COSMIIC-Community/NOVA/README.md

# COSMIIC-NOVA
Open-source high channel count impantable devices

## NOVA BACKGROUND
NOVA or "Neural Open-source Versatile Array" is a sub-project of the Cleveland Open Source Modular Implant Innovators Community (COSMIIC). The project goal is to design high channel count implantable medical devices for neural recording and modulation that can be added as modules to the COSMIIC system. Within each device folder, you will find sub-folders that contain documentation of the enclosure and electronics design, testing, and regulatory communications. More information on the COSMIIC system can be found [here](https://cosmiic.org/).

## NOVA TEAM
Electronics design: Cynthia Chestek, Alex Vaskov, Dylan Wallace, Olivia Lee  
Mechanical design: Doug Shire, Janet Gbur, Sonny Behan  
Regulatory Sponsorship: Paul Cederna  
COSMIIC Integration: Kevin Kilgore, Brian Smith, Joris Lambrecht, Jeremiah Ukwela  

## LICENSING
All of our design files are open-source! You are free to reference, share, and adapt this material according to Creative Commons License Attribution 4.0 ([CC-By-4.0](https://creativecommons.org/licenses/by/4.0/)).
This license requires you to give appropriate credit and indiciate if changes were made. Attribution should be made to either Case Western Reserve University and/or University of Michigan. Attribution instructions are also found in each sub-folder. General instructions can be found [here](https://wiki.creativecommons.org/wiki/best_practices_for_attribution).

## FUNDING
This effort is funded by the National Institute of Health under the SPARC Human Open Research Neural Engineering Technologies (HORNET) Initiative. Award 1U41NS129436-01 sub-project 7004.
 
## DISCLAIMER
The contents of this repository are subject to revision. No representation or warranty, express or implied, is provided in relation to the accuracy, correctness, completeness, or reliability of the information, opinions, or conclusions expressed in this repository.

The contents of this repository (the “Materials”) are experimental in nature and should be used with prudence and appropriate caution. Any use is voluntary and at your own risk.

The Materials are made available “as is” by UM (the University of Michigan and its trustees, directors, officers, employees, faculty, students, agents, affiliated organizations and their insurance carriers, if any), and any other contributors to this repository (collectively, “Providers”). Providers expressly disclaim all warranties, express or implied, arising in connection with the Materials, or arising out of a course of performance, dealing, or trade usage, including, without limitation, any warranties of title, noninfringement, merchantability, or fitness for a particular purpose.

Any user of the Materials agrees to forever indemnify, defend, and hold harmless Providers from and against, and to waive any and all claims against Providers for any and all claims, suits, demands, liability, loss or damage whatsoever, including attorneys' fees, whether direct or consequential, on account of any loss, injury, death or damage to any person or (including without limitation all agents and employees of Providers and all property owned by, leased to or used by either Providers) or on account of any loss or damages to business or reputations or privacy of any persons, arising in whole or in part in any way from use of the Materials or in any way connected therewith or in any way related thereto.
