COSMIIC-Community/NOVA/64 Channel Recording Module/FDA Communications/README.md

# Electronics Pre-Sub External Testing

## DESCRIPTION
Contains FDA pre-submission communications to add the NOVA (previously named HIVE) recording module to a pre-existing IDE that uses implanted electrodes. Sensitive information related to the existing IDE and clinical trial has been redacted from the documents.

## LICENSING
All of our design files are open-source! You are free to reference, share, and adapt this material according to Creative Commons License Attribution 4.0 ([CC-By-4.0](https://creativecommons.org/licenses/by/4.0/)). This license requires you to give appropriate credit and indiciate if changes were made. Attribution should be made to University of Michigan. Example statements can be found [here](https://wiki.creativecommons.org/wiki/best_practices_for_attribution).
