COSMIIC-Community/NOVA/64 Channel Recording Module/Design/PCB/Development Board V0.1/NOVA_DEV_V0-1_Picture.png

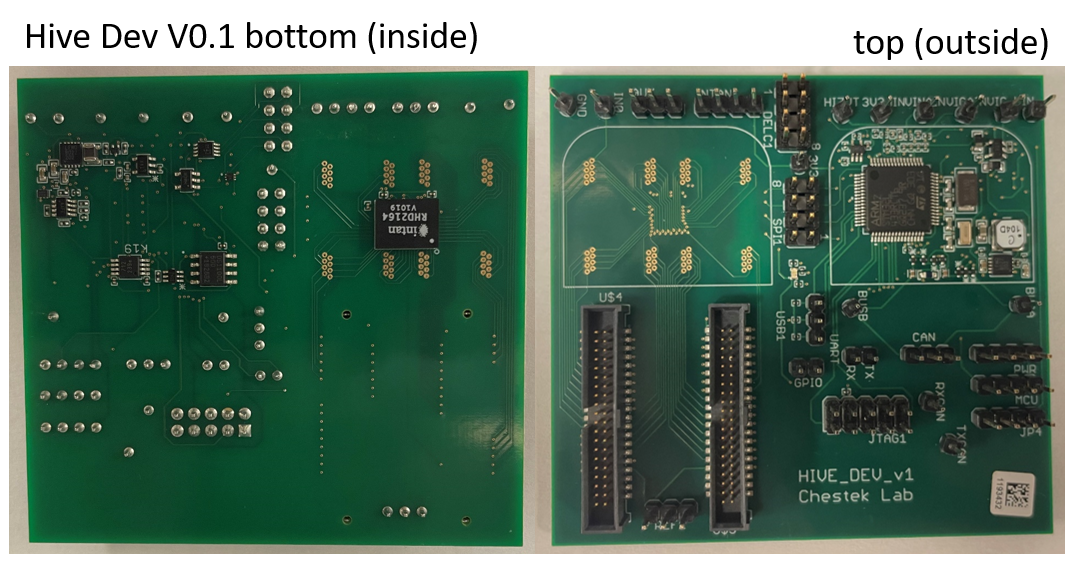
64 Channel Recording Module/Design/PCB/Development Board V0.1/NOVA_DEV_V0-1_Picture.png
