COSMIIC-Community/NOVA/64 Channel Recording Module/Design/PCB/NOVA V1/Output/BOM/BOM-UM-64NNP-V1.xlsx

Quantity | Designator | Description | Manufacturer | Manufacturer PN | Supplier 1 | Supplier Part Number 1
21 | C1, C8, C9, C12, C16, C20, C21, C22, C23, C24, C25, C26, C27, C34, C35, C39, C41, C42, C43, C701, C702 | Capacitor, Ceramic, 0.1uF, X7R, 16V, 10%, 0402 | Murata | GCM155R71C104KA55J | Digikey | 490-7998-1-ND
2 | C2, C3 | Capacitor, Ceramic, 8.0pF, C0G, 50V, 0.05pF, 0402 | Murata | GJM1555C1H8R0WB01D | Mouser | 81-GJM1555C1H8R0WB1D
6 | C4, C28, C36, C40, C44, C102 | Capacitor, Ceramic, 4.7uF, X5R, 10V, 20%, 0402 | Murata | GRM155R61A475MEAAD | Mouser | 81-GRM155R61A475MEAD
3 | C5, C33, C703 | Capacitor, Ceramic, 10nF, X7R, 25V, 10%, 0402 | KEMET | C0402C103J3RACTU | Mouser | 80-C0402C103J3R
2 | C6, C103 | Capacitor, Ceramic, 10uF, X5R, 10V, 20%, 0402 | Murata | GRM155R61A106ME11D | Mouser | 81-GRM155R61A106ME1D
2 | C7, C17 | Capacitor, Ceramic, 0.1uF, X7R, 100V, 10%, 0603 | Kyocera AVX | 06031C104K4Z2A | Mouser | 581-06031C104K4Z2A
2 | C10, C11 | Capacitor, Ceramic, 47uF, X5R, 25V, 20%, 1206 | Murata | C3216X5R1E476M160AC | Mouser | 810-C3216X5R1E476M
11 | C13, C14, C18, C19, C29, C31, C32, C101, C201, C202, C203 | Capacitor, Ceramic, 1.0uF, X5R, 25V, 10%, 0402 | TDK | CGB2A1X5R1E105K033BC | Mouser | 810-CGB2A1X5R1E105BC
2 | C15, C38 | Capacitor, Ceramic, 5.6pF, C0G, 50V, 10%, 0402 | Murata | GRM1555C1H5R6WA01D | Mouser | 81-GRM1555C1H5R6WA1D
1 | C30 | Capacitor, Ceramic, 68pF, C0G, 50V, 5%, 0402 | Murata | GRM1555C1H680JA01D | Mouser | 81-GRM1555C1H680JA1D
1 | C37 | Capacitor, Ceramic, 680pF, C0G, 100V, 5%, 0603 | Murata | GCM1885C2A681JA16D | Mouser | 81-GCM1885C2A681J16D
64 | C811, C812, C813, C814, C815, C816, C817, C818, C821, C822, C823, C824, C825, C826, C827, C828, C831, C832, C833, C834, C835, C836, C837, C838, C841, C842, C843, C844, C845, C846, C847, C848, C851, C852, C853, C854, C855, C856, C857, C858, C861, C862, C863, C864, C865, C866, C867, C868, C871, C872, C873, C874, C875, C876, C877, C878, C881, C882, C883, C884, C885, C886, C887, C888 | Capacitor, Ceramic, 680pF, C0G, 100V, 5%, 0402 | TDK | CGA2B1C0G2A681J050BC | Mouser | 810-CGA2B1C0G2A681J5
1 | D1 | LED Green 20mA 2.2V 45mcd 0402 | Lumex | SML-LX0402SUGC-TR | Mouser | 696-SML-LX0402SUGCTR
1 | D2 | LED, Blue, 2mA, 2.65V, 15mcd, 0402 | Kingbright | APHHS1005LQBC/D-V | Mouser | 604-APHHS1005LQBC/DV
7 | D5, D6, D7, D8, D9, D11, D12 | Diode, Schottky, 30V, 100mA, SOD-923 | Toshiba | 1SS416,L3M | Mouser | 757-1SS416L3M
64 | D811, D812, D813, D814, D815, D816, D817, D818, D821, D822, D823, D824, D825, D826, D827, D828, D831, D832, D833, D834, D835, D836, D837, D838, D841, D842, D843, D844, D845, D846, D847, D848, D851, D852, D853, D854, D855, D856, D857, D858, D861, D862, D863, D864, D865, D866, D867, D868, D871, D872, D873, D874, D875, D876, D877, D878, D881, D882, D883, D884, D885, D886, D887, D888 | TVS Diode, Bidirectional, ±5.3V, 3.0A, SOD-882 | Littelfuse | SP3022-01ETG | Mouser | 576-SP3022-01ETG
5 | FB1, FB2, FB3, FB4, FB5 | Ferrite Bead, 700mA, 0402 | Murata | BLM15EG221SH1D | Mouser | 81-BLM15EG221SH1D
1 | J1 | Connector, 1.27 mm, 2x5, Male, TH | Samtec | FTSH-105-01-F-D-K | Mouser | 200-FTSH10501FDK
1 | J2 | Header, Male, TH, 2.54mm, 1x7 | Samtec | TSW-107-07-F-S | Mouser | 200-TSW10707FS
1 | L1 | Inductor, 2.2uH, 1.76A, 1008 | TDK | VLS252010HBX-2R2M-1 | Mouser | 810-VLS25201HBX2R2M1
1 | L6 | Inductor, Unshielded, 33nH, 350mA, 0402 | Murata | LQG15HS33NJ02D | Mouser | 81-LQG15HS33NJ02D
2 | L101, L201 | Inductor, Shielded, 47uH, 20%, 0.380A | Coilcraft | LPS4012-473MRC | Mouser | 994-LPS4012-473MRC
1 | M1 | MOSFET, Dual N-chan/P-chan, ±60V, SOT563 | Diodes Inc | DMG1029SV-7 | Mouser | 621-DMG1029SV-7
1 | Q1 | BJT, PNP, -50V, -0.1A, SOT-723 | Rohm | 2SAR523MT2L | Mouser | 755-2SAR523MT2L
3 | R1, R14, R22 | Resistor, 2M, 40V, 40mW, 1%, 0402 | Panasonic | ERJ-2GEJ205X | Mouser | 667-ERJ-2GEJ205X
1 | R2 | Resistor, 10.0k, 1%, 50V, 0.1W, 0402 | Panasonic | ERJ-2RKF1002X | Mouser | 667-ERJ-2RKF1002X
4 | R3, R24, R35, R36 | Resistor, 4.99M, 1%, 50V, 0.062W, 0402 | Vishay Dale | CRCW04024M99FKED | Mouser | 71-CRCW04024M99FKED
3 | R4, R7, R9 | Resistor, Zero ohms, 0603 | Yageo | RC0603JR-100RL | Mouser | 603-RC0603JR-100RL
1 | R8 | Resistor, 0.1, 1%, 50V, 0.25W, 0402 | Panasonic | ERJ-2BWFR100X | Mouser | 667-ERJ-2BWFR100X
2 | R10, R13 | ESD Suppressor, 12V, 0603 | Bourns | CGA0603MLC-12E | Mouser | 652-CGA0603MLC-12E
2 | R11, R20 | Resistor, 4.12M, 50V, 62mW, 1%, 0402 | Vishay Dale | CRCW04024M12FKED | Mouser | 71-CRCW04024M12FKED
5 | R15, R101, R104, R201, R204 | Resistor, Zero ohms, 0402 | Panasonic | ERJ-2GE0R00X | Mouser | 667-ERJ-2GE0R00X
6 | R16, R18, R27, R29, R30, R78 | Resistor, 1k, 1%, 50V, 0.1W, 0402 | Panasonic | ERJ-2RKF1001X | Mouser | 667-ERJ-2RKF1001X
2 | R19, R21 | Resistor, 5.1k, 1%, 50V, 0.1W, 0402 | Panasonic | ERJ-2RKF5101X | Mouser | 667-ERJ-2RKF5101X
4 | R25, R26, R28, R31 | Resistor, 49.9k, 1%, 50V, 0.1W, 0402 | Panasonic | ERJ-2RKF4992X | Mouser | 667-ERJ-2RKF4992X
1 | R32 | Resistor, 84.5k, 1%, 50V, 0.1W, 0402 | Panasonic | ERJ-2RKF8452X | Mouser | 667-ERJ-2RKF8452X
1 | R33 | Resistor, 1.00M, 1%, 50V, 0.1W, 0402 | Panasonic | ERJ-2RKF1004X | Mouser | 667-ERJ-2RKF1004X
2 | U1, U15 | Op Amp, Rail-to-Rail, 95kHz, WLCSP-6 | Analog Devices | AD8505ACBZ-R7 | Digikey | AD8505ACBZ-R7CT-ND
1 | U2 | Microcontroller, ARM Cortex-M4, 32-bit, 4MB Flash, 2.5MB RAM, SMPS, BGA-132 | ST Microelectronics | STM32U5A5QJI6Q | Mouser | 511-STM32U5A5QJI6Q
2 | U3, U6 | LDO, 1-5.5V, ADJ, 150mA, TSOT-23-5 | Analog Devices | ADP161AUJZ-R7 | Mouser | 584-ADP161AUJZ-R7
1 | U4 | Current Sense, HIgh Side, 1.6-28V, 200V/V, SOT23-5 | Maxim | MAX9938FEUK+T | Mouser | 700-MAX9938FEUK+T
1 | U5 | FRAM, 8 Mbit (1024k x 8), SPI, 1.8-3.6V, QFN-8 | Cypress | CY15B108QI-20LPXI | Heisener | CY15B108QI-20LPXI
1 | U8 | Comparator, Dual, 40ns, VSSOP8 | Texas Instruments | TLV3202AQDGKRQ1 | Mouser | 595-TLV3202AQDGKRQ1
2 | U9, U16 | XOR, 5.5V, uPAk6 | ON Semiconductor | NC7SZ86L6X | Arrow Electronics | NC7SZ86L6X
1 | U10 | Digital Isolator, 110Mbps, 2.7-5.5V, uSOP8 | NVE | IL 712-1ETR7 | Digi-Key | 390-IL712-1ETR7CT-ND
1 | U11 | Silicon delay, 3-3.6V, uSOP8 | Maxim | DS1100LU-500+ | Mouser | 700-DS1100LU-500
2 | U12, U17 | D FLIPFLOP, 5.5V, uPAk6 | ON Semiconductor | NC7SZ175L6X | Digikey | NC7SZ175L6XFSCT-ND
1 | U13 | LDO, -1.2-20V, -200mA, SOT23-5 | Analog Devices | LT1964ES5-BYP#PBF | Digi-Key | LT1964ES5-BYP#TRMPBFCT-ND
2 | U101, U201 | Buck Converter, 2.7-20V, 50mA DFN10 | Analog Devices | LTC3388EDD-3#TRPBF | Mouser | 584-C3388EDD-3TRPBF
1 | U701 | Digital Electrophysiology Interface Chip, BGA-104 | Intan Technologies | RHD2164 | Intan Technologies | RHD2164
1 | Y1 | Crystal, 32.768kHz, 6.0pF, 90k, 20ppm | ECS | ECS-.327-6-12-TR | Mouser | 520-ECS-.327-6-12-TR
1 | Y2 | Crystal, 48MHz, 10ppm, 8pF | ECS | ECS-480-8-47B2-CKM-TR | Mouser | 520-ECS480847B2CKMTR
