COSMIIC-Community/NOVA/64 Channel Recording Module/Design/PCB/NOVA V1/Output/ExportSTEP/UM-64NNP-V1 rev 0.18_norail.step

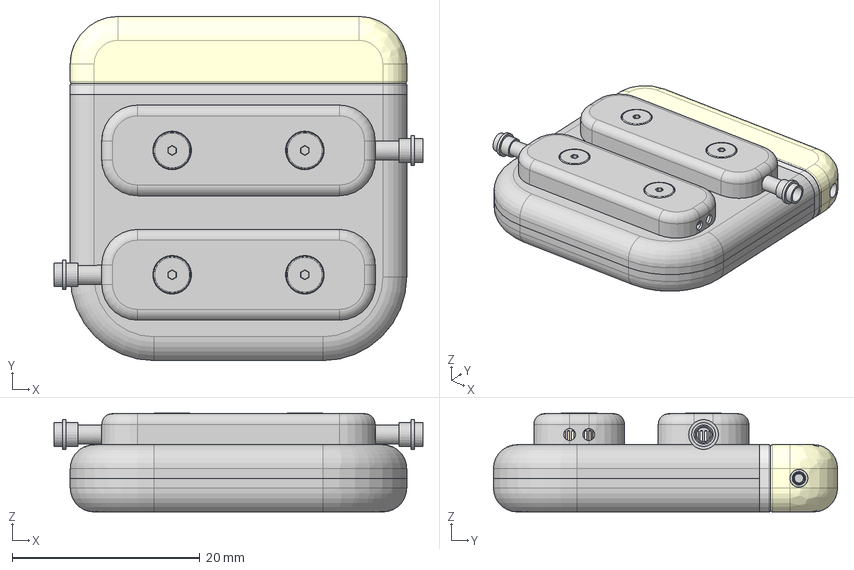
[picture p3: CAD file, 2026-10-12]
64 Channel Recording Module/Design/PCB/NOVA V1/Output/ExportSTEP/UM-64NNP-V1 rev 0.18_norail.step
39.3 x 36.6 x 10.5 mm
capsule x 78
innard x 39
top_cover x 39
Extruded x 356
bigPin x 130
Capsule x 6
Encapsulation x 12
TopCover x 6
LQG15HS3N0S02D
vls252010hbx-1
BGA132CP50_12X12_700X700X60B28
pinShape x 24
ball x 12
BLM15PX331SN1D x 5
LPS4012 x 2
Leader x 31
MSOP-8
Thermal_Shape x 2
lead x 23
64 Stack Square Header_14Mar2023
C12-PM0007-042413 x 2
X572802 CONDUCTOR-042413 x 2
X572802-Washer-042413 x 2
X572802-Spring-042413 x 2
x600883-042413 x 2
X600883-Washer-042413 x 2
X600883-Spring-042413 x 2
Horizontal 64 Stack Square Lidthrough_25Apr2023
Anchor Bracket_15Feb2023
Ground Pin_25Apr2023
Brian Round Bipolar Flange_26Apr2023 x 2
Brian Round Bipolar Feedthrough Wire_25Apr2023 x 4
Brian Round Bipolar Ceramic_26Aug2023 x 2
Horizontal 64 Square Bottom Enclosure_10Feb2024
Weld Band_29Jun2023
Horizontal 64 Square Top Enclosure_10Feb2024
8 Pin Flange_16Sep2022 x 8
8 Pin Ceramic_3Jan2022 x 8
8 Pin Wire_16Sep2022 x 64
2-56 Standoff_30Mar2023 x 4
Doug34setscrew x 4
D64 Long Cap_29Jun2023 x 2
Cap Extension_13Jun2023 x 2
