COSMIIC-Community/NOVA/64 Channel Recording Module/Design/Firmware/manual/Title.md

@mainpage COSMIIC Nova Module Documentation

## Welcome to COSMIIC!

We are establishing and sustaining an open source, modular network of active implantable devices for use in fundamental neuroscience, animal, and early feasibility human research. Our open source concept includes all aspects of the implantable system that are necessary for pre-clinical and human use: hardware, software, mechanical components, test documents, regulatory documents, and instruction manuals. The COSMIIC System has demonstrated success in an early feasibility human study, providing a strong reference for new uses of the device. Our goal with establishing COSMIIC is to make this system available to the entire research community in an open source, collaborative environment.

**Discover more about our technology on our documentation site:** **[docs.cosmiic.org](https://docs.cosmiic.org)**

## Introduction
This website contains documentation for the [Nova Module](https://docs.cosmiic.org/In-Development-Modules/Nova-Module) firmware application repository. The Nova module currently implements a minumum set of features that enable interoperability within the network, based off the COSMIIC generic module template.

## Supported Boards
This Nova codebase is based on the STM32U5 microcontroller unlike the STM32L433 microcontroller used by the generic module firmware. The codebase was written with the use of the STM32 Hardware Abstraction Layer (HAL) and CMSIS, which allows for translation to other STM32 series microcontrollers.

## Licensing
Check the [licensing page](https://docs.cosmiic.org/Community/Licensing) on the [documentation site](https://docs.cosmiic.org) for licensing information.
