COSMIIC-Community/NOVA/64 Channel Recording Module/Design/PCB/Revisions/2024-07-18_UM-64NNP-V1_REWORK1.docx

Document Number | UM-64NNP-V1_REWORK1
Author | Alex Campean
Client | University of Michigan / Chestek Lab
Project | UM-64NNP-V1
Statement of Work | 1. Remove U16 and replace with Texas Instruments SN74LVC1G32DRYR or equivalent OR gate. a. If using hot air, a silicone cover is recommended to protect the flex circuit from damage. b. Recommended re-work settings are 275⁰C hot air, 160⁰C pre-heat, A30 (3rd to last setting) air flow. 2. Cut the EMG_SCK trace going to U17, pin 6 (D Flip Flop CLRn input pin) as shown. 3. Wire an Onsemi NC7SV14P5X or equivalent inverter as shown. a. Pin 2 = EMG_SCK b. Pin 3 = GND c. Pin 4 = U17 pin6 (CLRn) d. Pin 5 = DVDD

Description

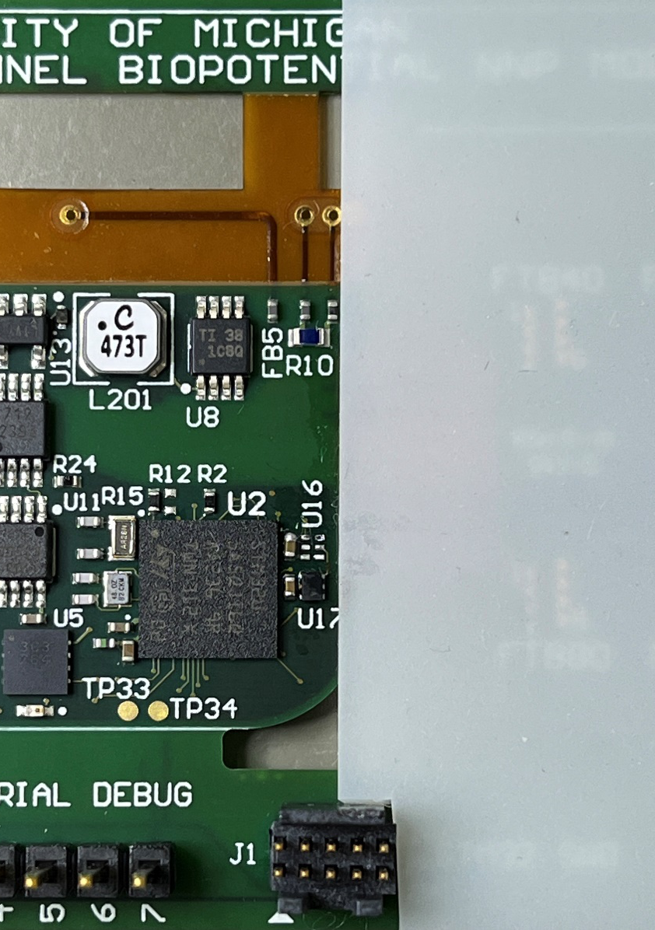
[picture p4: figure]

Remove U16 and replace with

SN74LVC1G32DRYR (replacement part not shown)

Silicone cover to

protect flex area.

Description

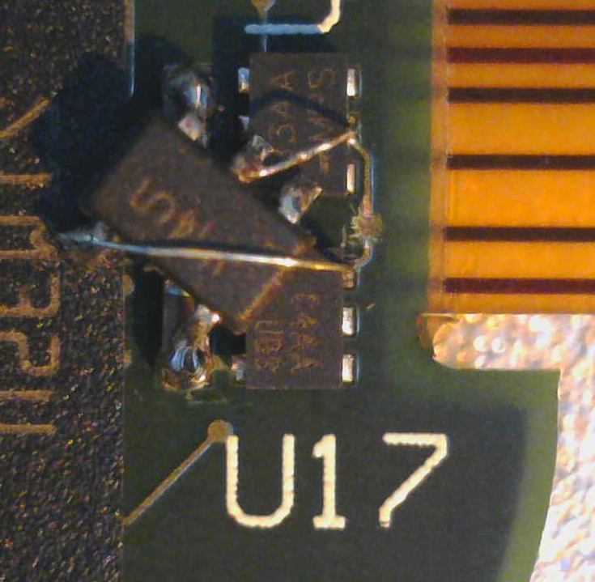
[picture p5: figure]
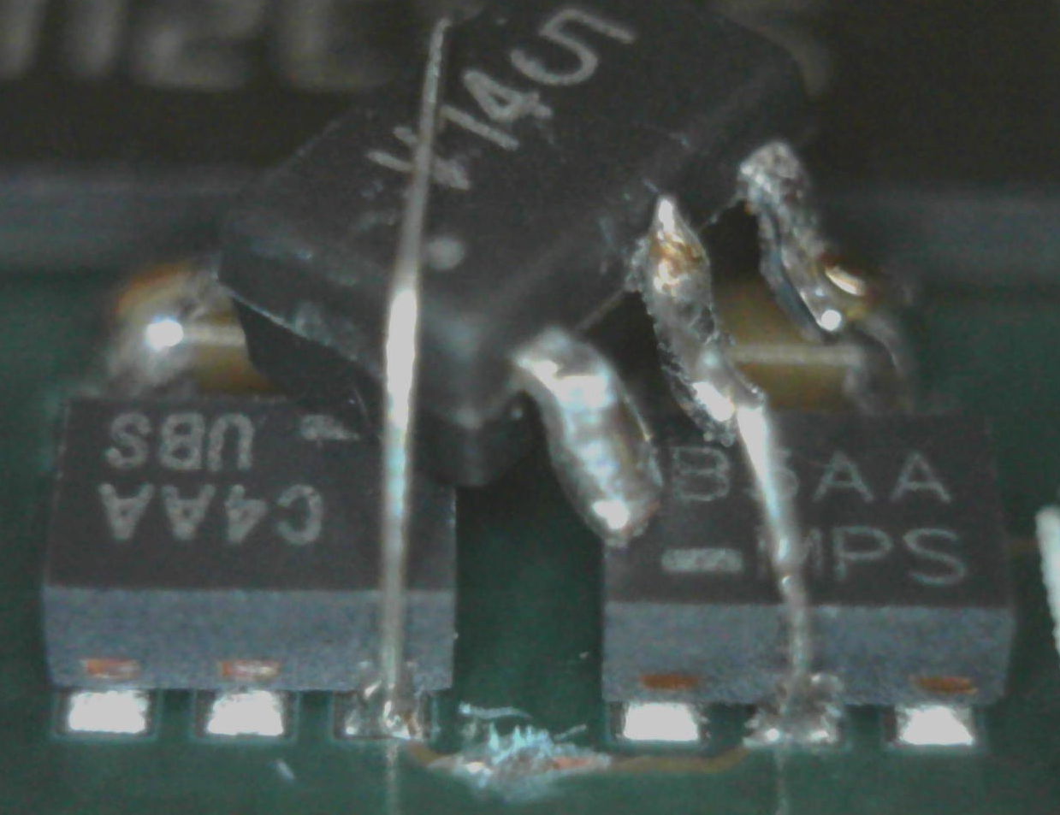
[picture p6: figure]
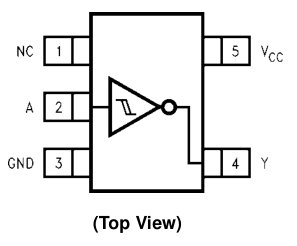
[picture p7: figure]

Cut EMG_SCK trace here

From: EMG_SCK

To: U17 pin6 (CLRn)

NC7SV14P5X

5 = DVDD

4 = U17 pin6 (CLRn)

3 = GND

2 = EMG_SCK

SOLDER

SOLDER

SOLDER

SOLDER

SOLDER

SOLDER

2024-07-18_UM-64NNP-V1_REWORK1.docx 2025-03-05 1:28 PM 2 of 2

Business Confidential Alex Campean acampean@carrollbiomedical.com Al
