COSMIIC-Community/NOVA/64 Channel Recording Module/Design/Mechanical/Design PDFs/NOVA 64ch Assembly.pdf

A | A

6

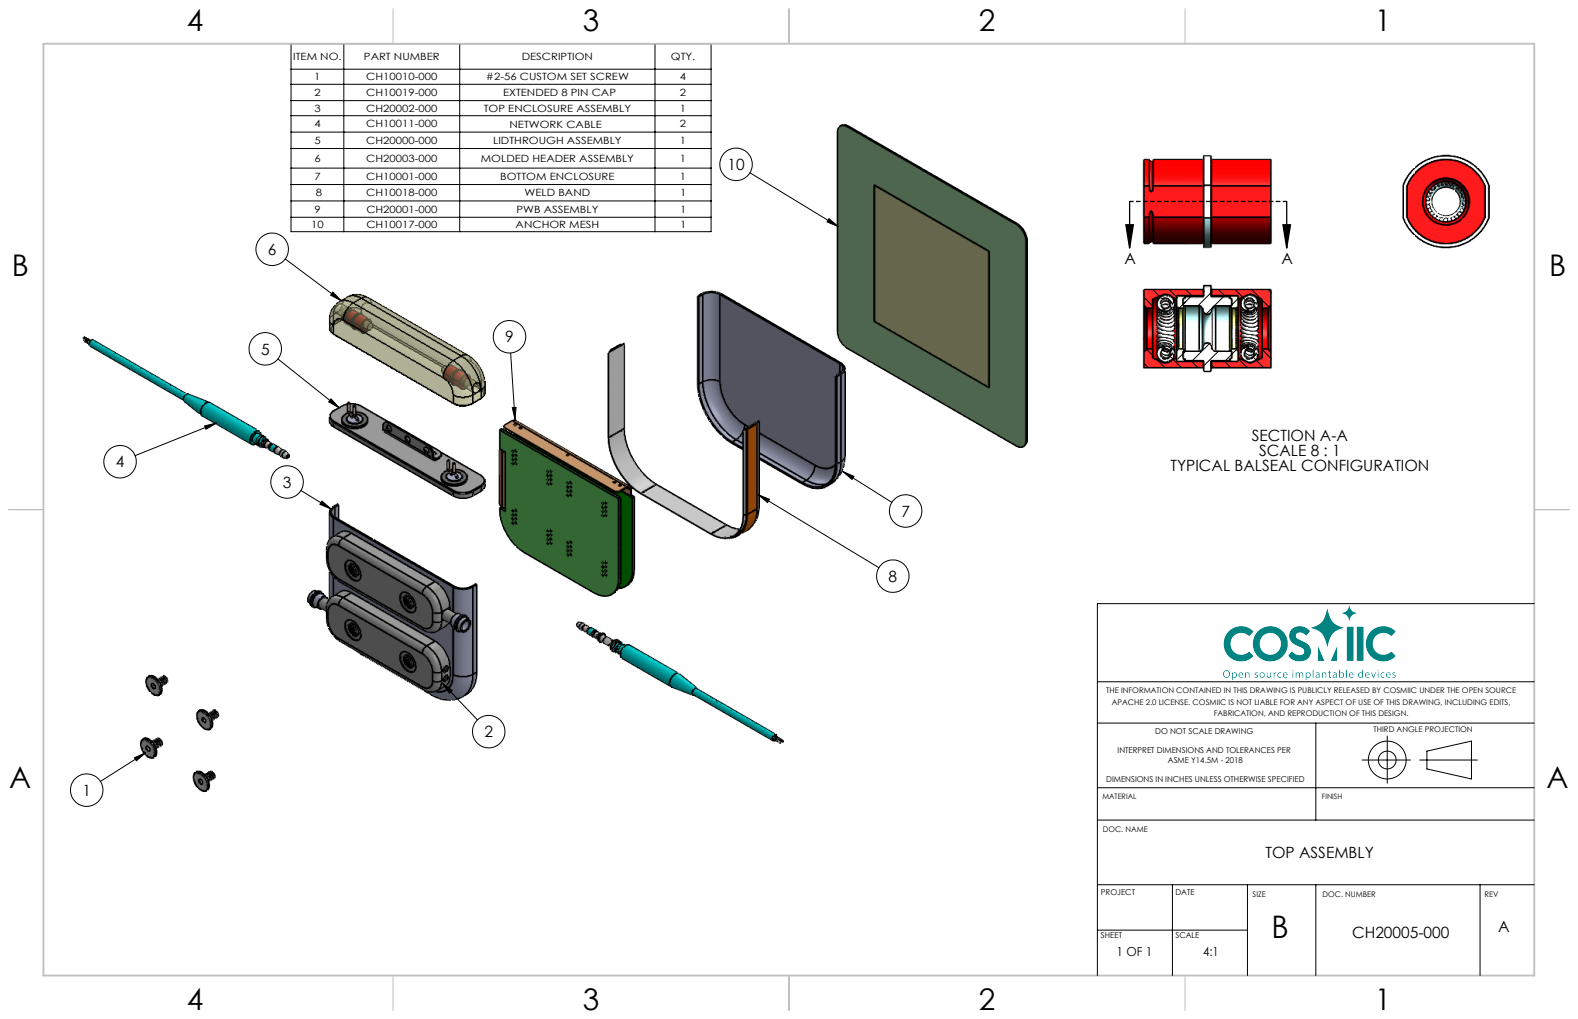
[picture p11: page 1]
SECTION A-A SCALE 8 : 1; DOC. NUMBER; REV; SIZE; DOC. NAME; PROJECT; DATE; MATERIAL; FINISH; ASME Y14.5M - 2018; SHEET; SCALE; TOP ASSEMBLY

ITEM NO. | PART NUMBER | DESCRIPTION | QTY.
1 | CH10010-000 | #2-56 CUSTOM SET SCREW | 4
2 | CH10019-000 | EXTENDED 8 PIN CAP | 2
3 | CH20002-000 | TOP ENCLOSURE ASSEMBLY | 1
4 | CH10011-000 | NETWORK CABLE | 2
5 | CH20000-000 | LIDTHROUGH ASSEMBLY | 1
6 | CH20003-000 | MOLDED HEADER ASSEMBLY | 1
7 | CH10001-000 | BOTTOM ENCLOSURE | 1
8 | CH10018-000 | WELD BAND | 1
9 | CH20001-000 | PWB ASSEMBLY | 1
10 | CH10017-000 | ANCHOR MESH | 1

TYPICAL BALSEAL CONFIGURATION

THE INFORMATION CONTAINED IN THIS DRAWING IS PUBLICLY RELEASED BY COSMIIC UNDER THE OPEN SOURCE
APACHE 2.0 LICENSE. COSMIIC IS NOT LIABLE FOR ANY ASPECT OF USE OF THIS DRAWING, INCLUDING EDITS,

FABRICATION, AND REPRODUCTION OF THIS DESIGN.

DO NOT SCALE DRAWING

THIRD ANGLE PROJECTION

INTERPRET DIMENSIONS AND TOLERANCES PER

DIMENSIONS IN INCHES UNLESS OTHERWISE SPECIFIED
