COSMIIC-Community/NOVA/64 Channel Recording Module/Design/Mechanical/Design PDFs/PCB.pdf

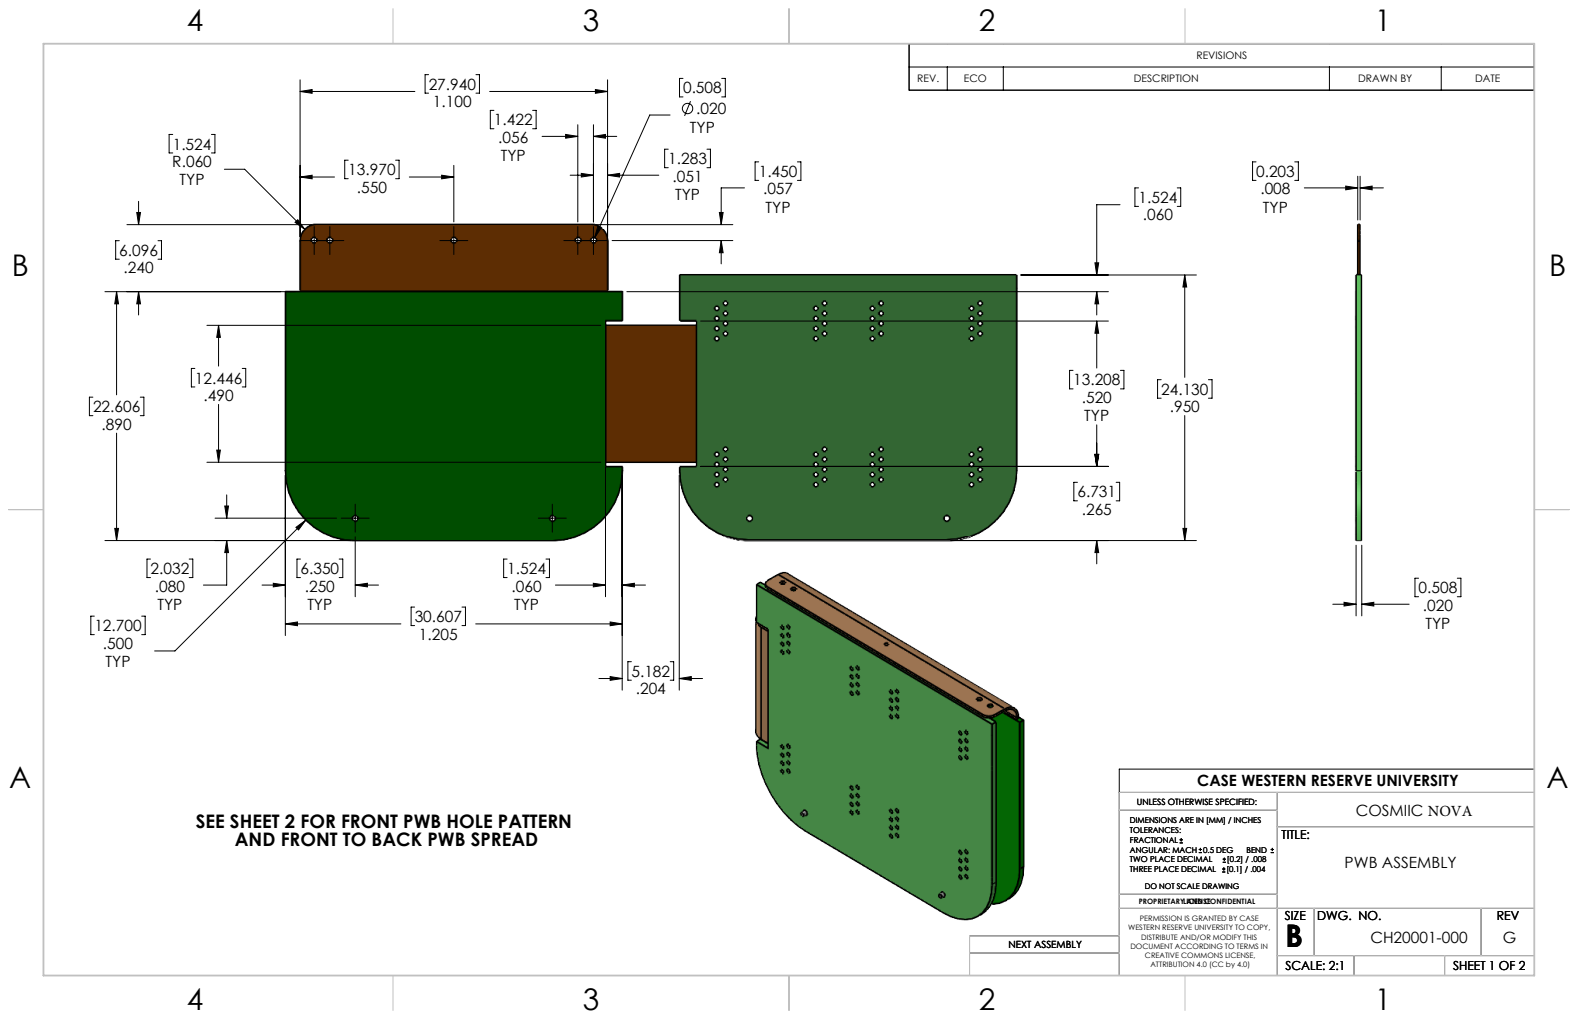
[picture p12: page 1]
PWB ASSEMBLY; TWO PLACE DECIMAL; NEXT ASSEMBLY; COSMIIC NOVA

REVISIONS

REV. | ECO | DESCRIPTION | DRAWN BY | DATE

CASE WESTERN RESERVE UNIVERSITY

UNLESS OTHERWISE SPECIFIED:
DIMENSIONS ARE IN [MM] / INCHES
TOLERANCES:
FRACTIONAL
ANGULAR: MACH 0.5 DEG BEND
THREE PLACE DECIMAL [0.1] / .004
DO NOT SCALE DRAWING
PROPRIETARY AND CONFIDENTIAL

SEE SHEET 2 FOR FRONT PWB HOLE PATTERN
AND FRONT TO BACK PWB SPREAD

PERMISSION IS GRANTED BY CASE WESTERN RESERVE UNIVERSITY TO COPY, DISTRIBUTE AND/OR MODIFY THIS DOCUMENT ACCORDING TO TERMS IN CREATIVE COMMONS LICENSE, ATTRIBUTION 4.0 (CC by 4.0) | SIZE SIZE SIZE B B B | DWG. NO. DWG. NO. DWG. NO. CH20001-000 | REV REV REV G

SCALE: 2:1 SCALE: 2:1 SCALE: 2:1 | | SHEET 1 OF 2 SHEET 1 OF 2 SHEET 1 OF 2

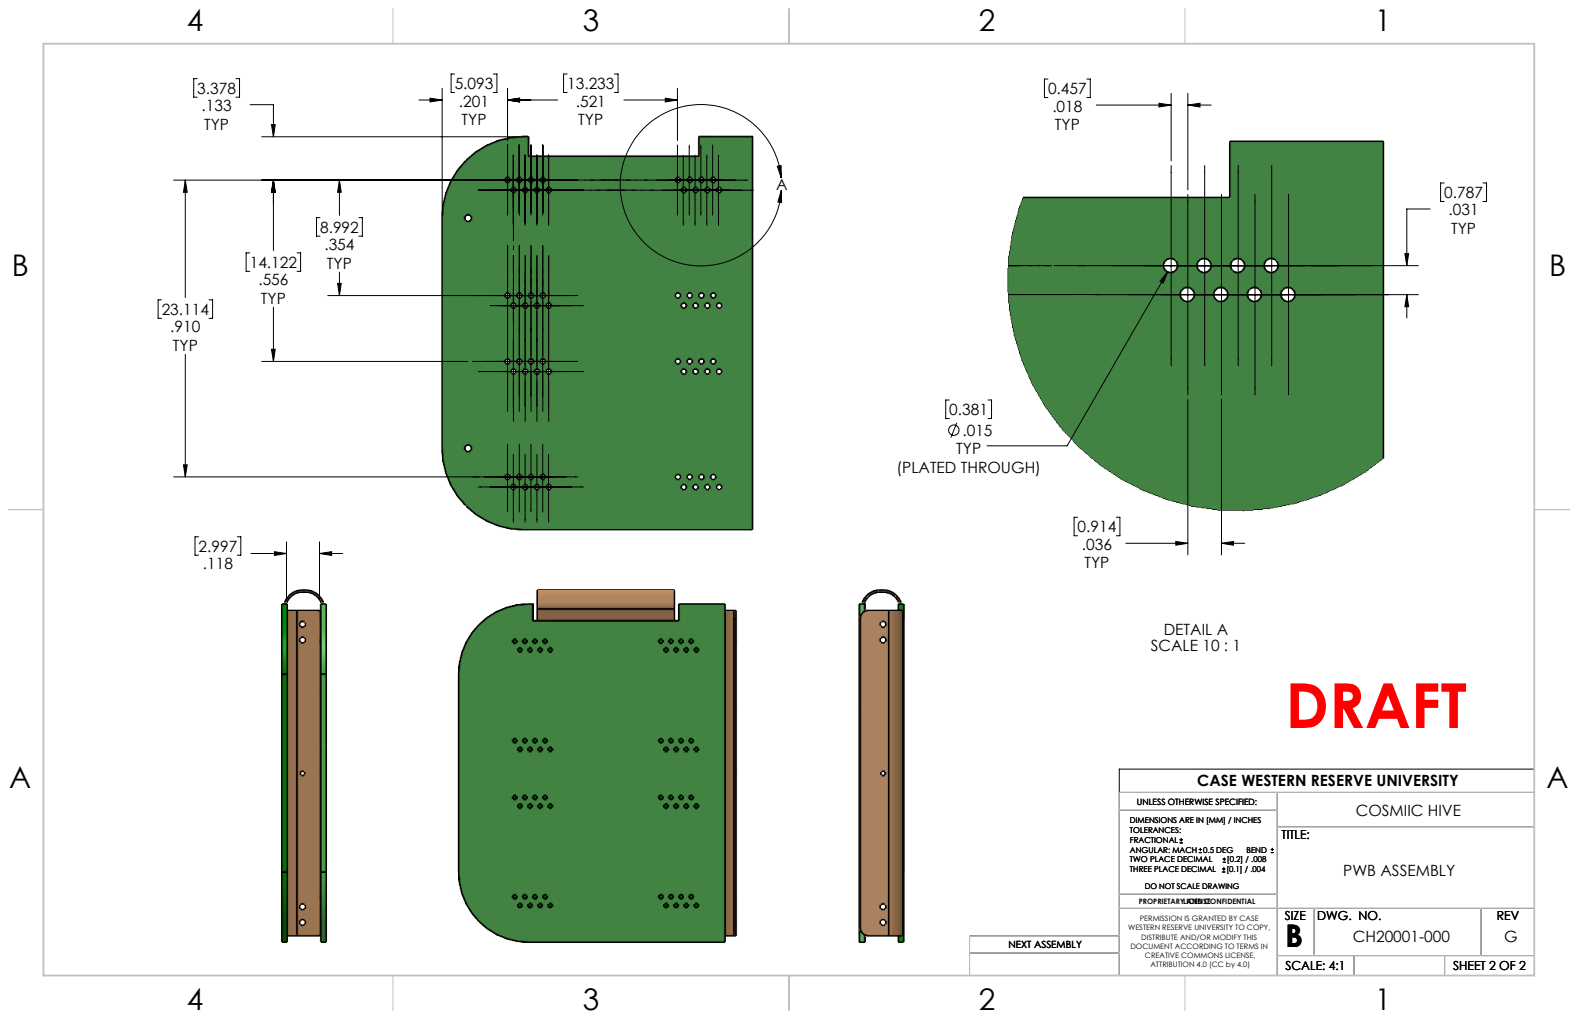
[picture p13: page 2]
TYP 23.114; (PLATED THROUGH); DETAIL A SCALE 10 : 1; PWB ASSEMBLY; TWO PLACE DECIMAL; NEXT ASSEMBLY; COSMIIC HIVE

CASE WESTERN RESERVE UNIVERSITY

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

SCALE: 4:1 SCALE: 4:1 SCALE: 4:1 | | SHEET 2 OF 2 SHEET 2 OF 2 SHEET 2 OF 2
