COSMIIC-Community/NOVA/64 Channel Recording Module/Design/PCB/NOVA V1/Output/PDF/UM-64NNP-V1 PCB ASSY.PDF

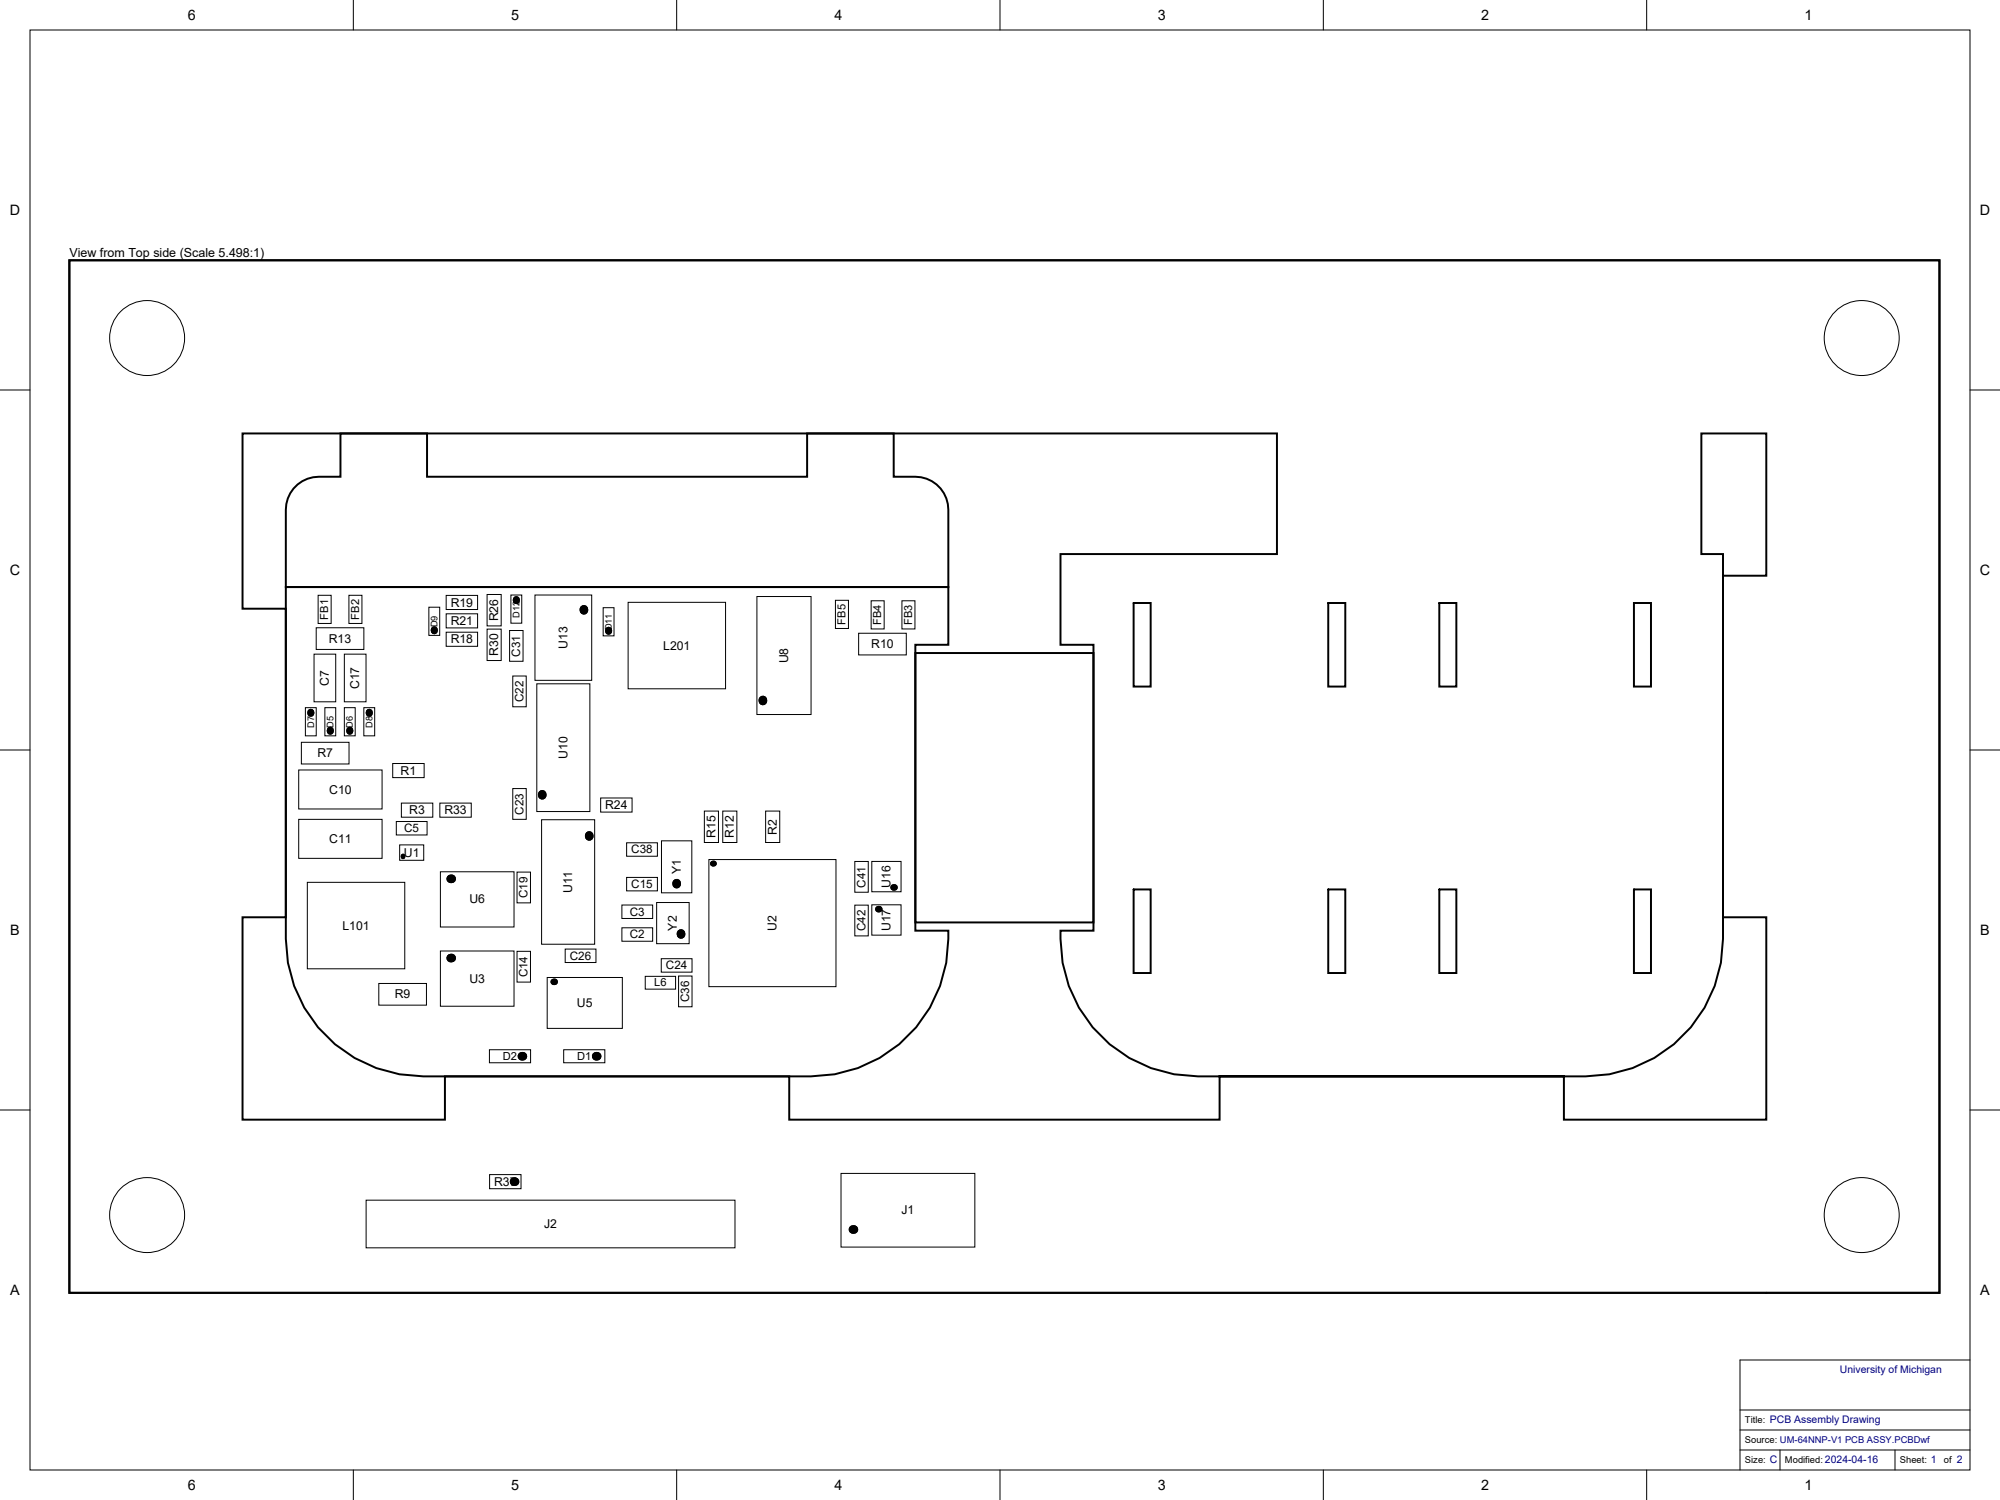
[picture p18: page 1]

View from Top side (Scale 5.498:1)

Source: UM-64NNP-V1 PCB ASSY.PCBDwf

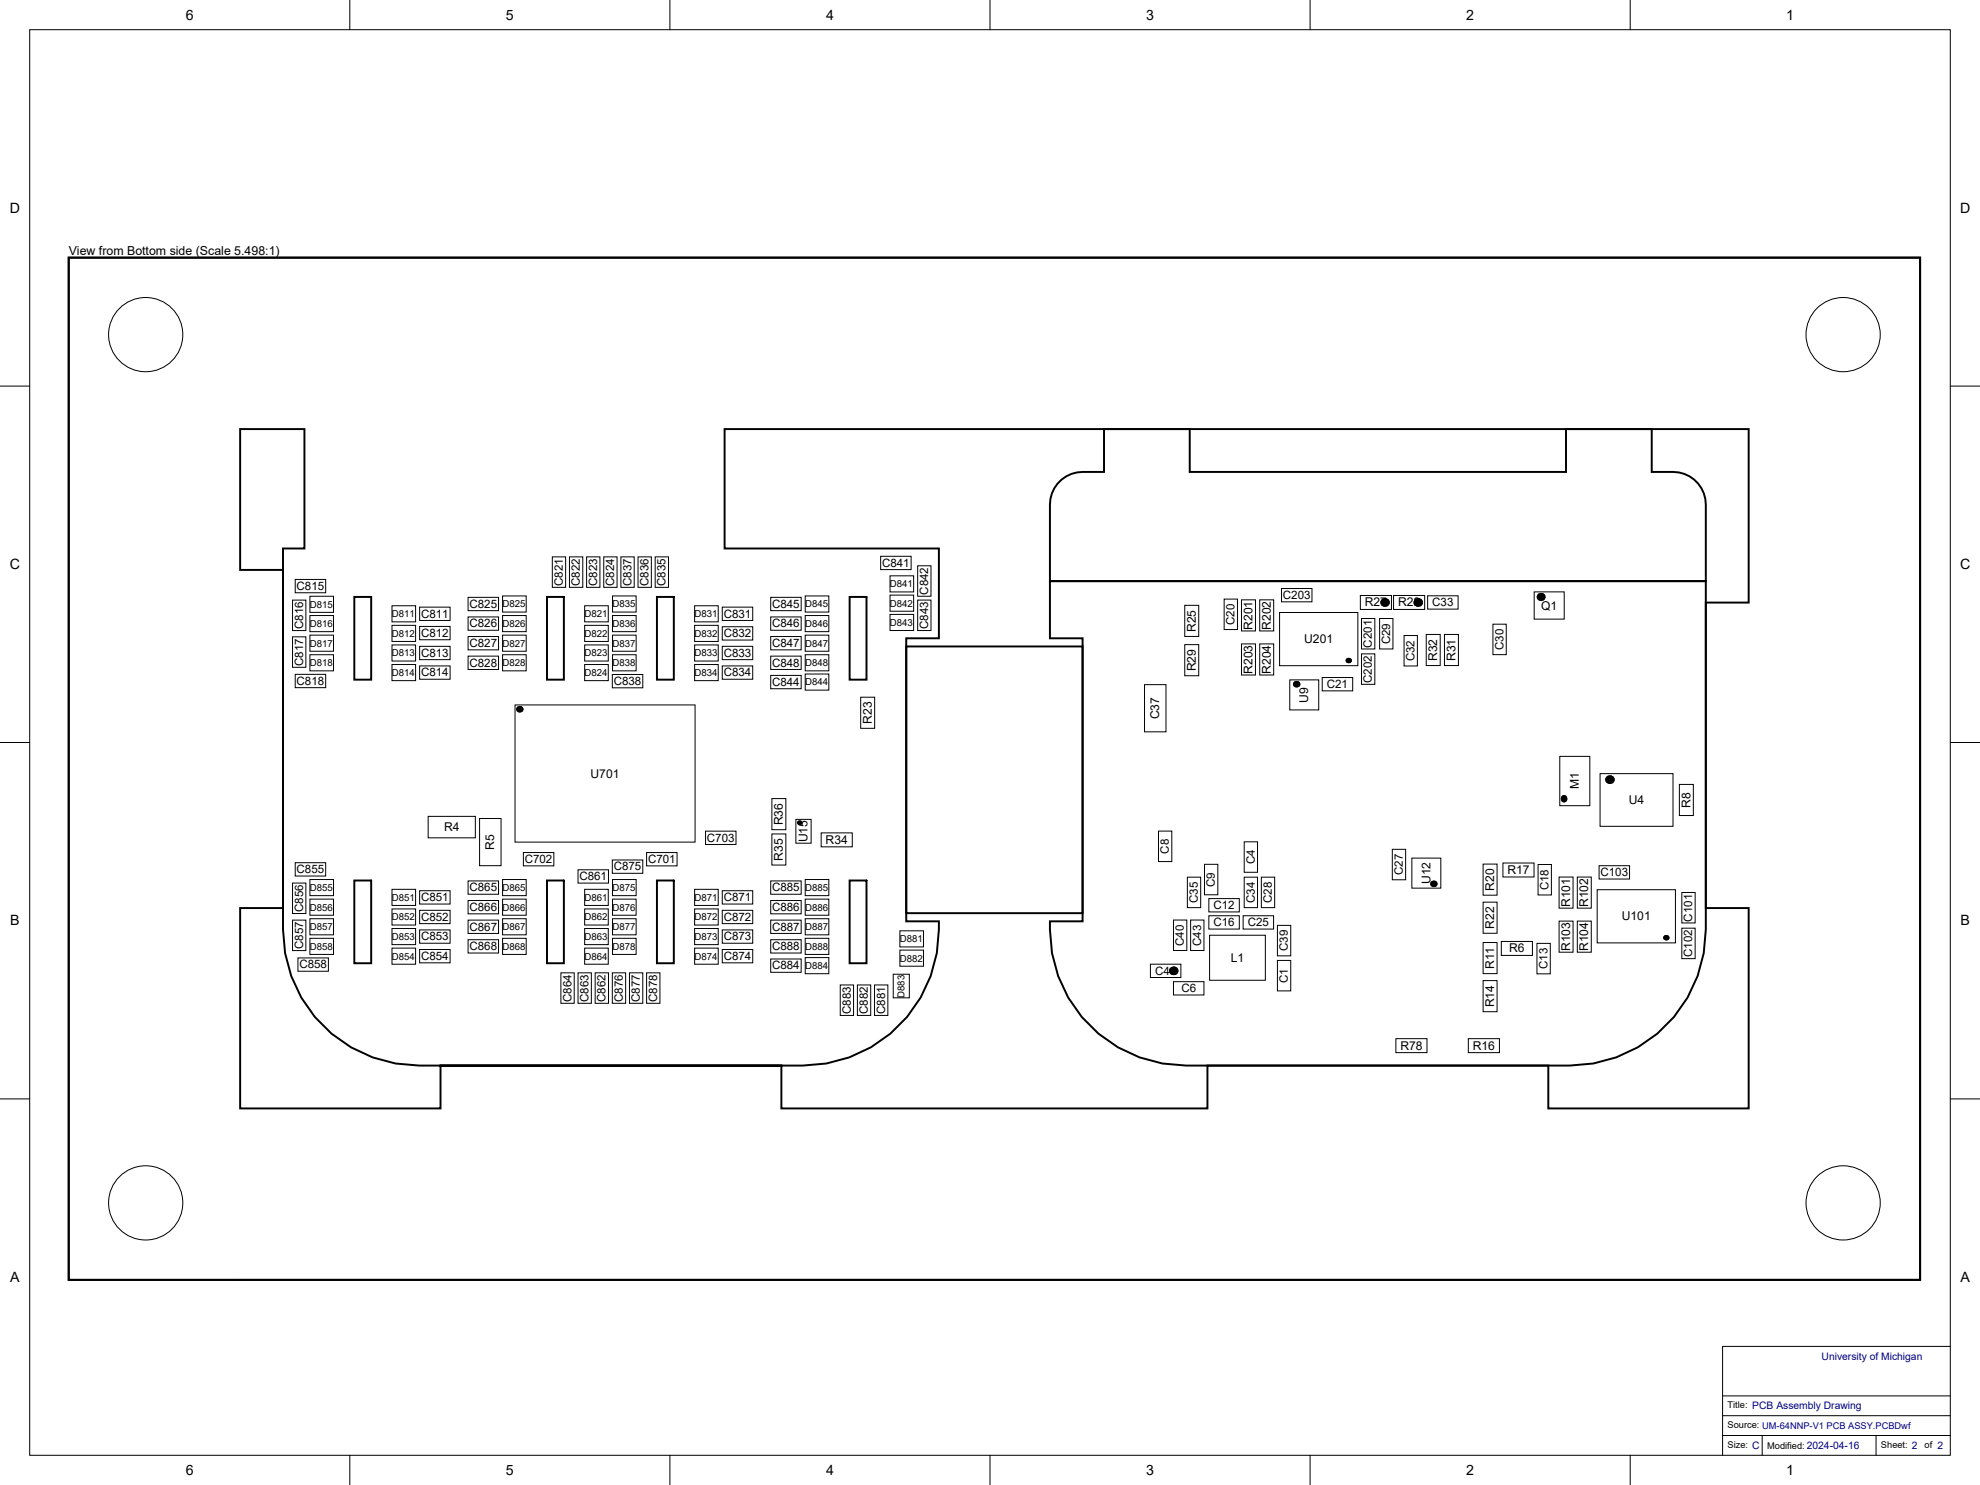
[picture p19: page 2]

View from Bottom side (Scale 5.498:1)

Source: UM-64NNP-V1 PCB ASSY.PCBDwf
