COSMIIC-Community/NOVA/64 Channel Recording Module/Design/PCB/NOVA V1/Output/PDF/UM-64NNP-V1 PCB FAB.PDF

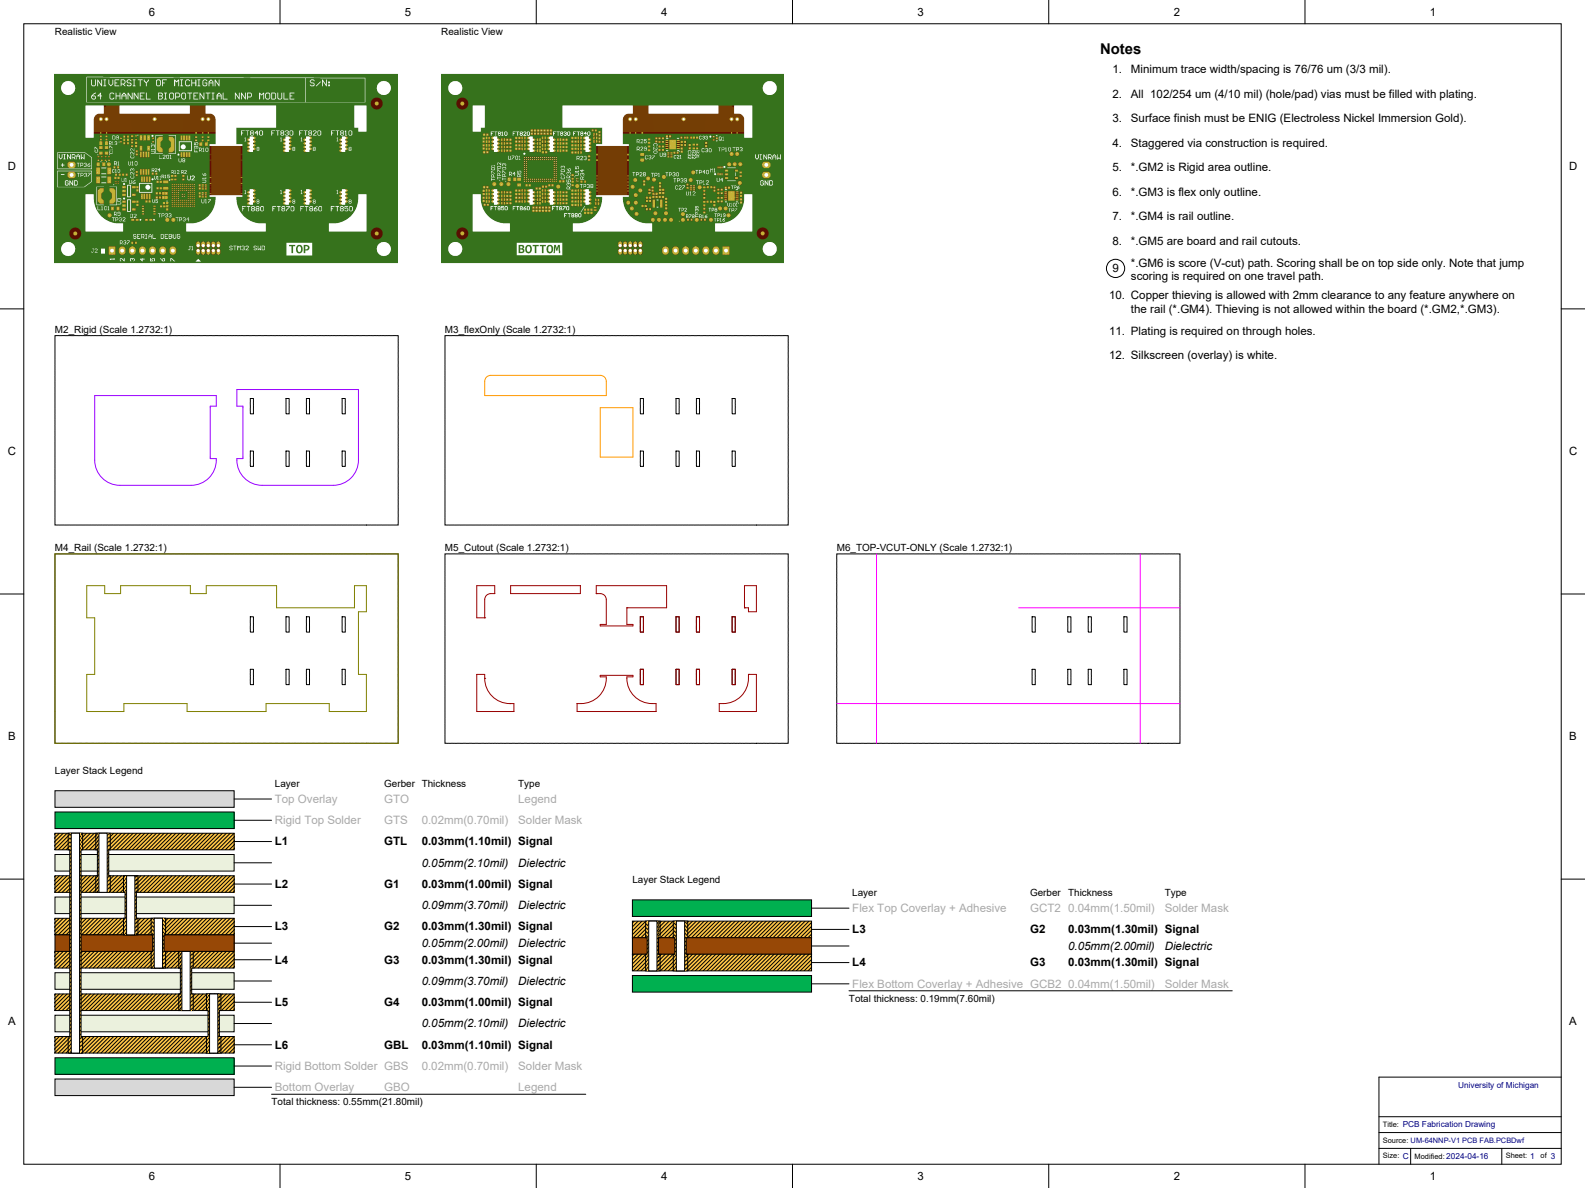
[picture p20: page 1]

Notes
1. Minimum trace width/spacing is 76/76 um (3/3 mil).

2. All 102/254 um (4/10 mil) (hole/pad) vias must be filled with plating.

3. Surface finish must be ENIG (Electroless Nickel Immersion Gold).

4. Staggered via construction is required.

5. *.GM2 is Rigid area outline.

6. *.GM3 is flex only outline.

8. *.GM5 are board and rail cutouts.
*.GM6 is score (V-cut) path. Scoring shall be on top side only. Note that jump
scoring is required on one travel path.
Copper thieving is allowed with 2mm clearance to any feature anywhere on
the rail (*.GM4). Thieving is not allowed within the board (*.GM2,*.GM3).
11. Plating is required on through holes.

12. Silkscreen (overlay) is white.

Flex Bottom Coverlay + Adhesive GCB2 0.04mm(1.50mil) Solder Mask
Total thickness: 0.19mm(7.60mil)

Rigid Bottom Solder GBS 0.02mm(0.70mil) Solder Mask
Total thickness: 0.55mm(21.80mil)

Source: UM-64NNP-V1 PCB FAB.PCBDwf

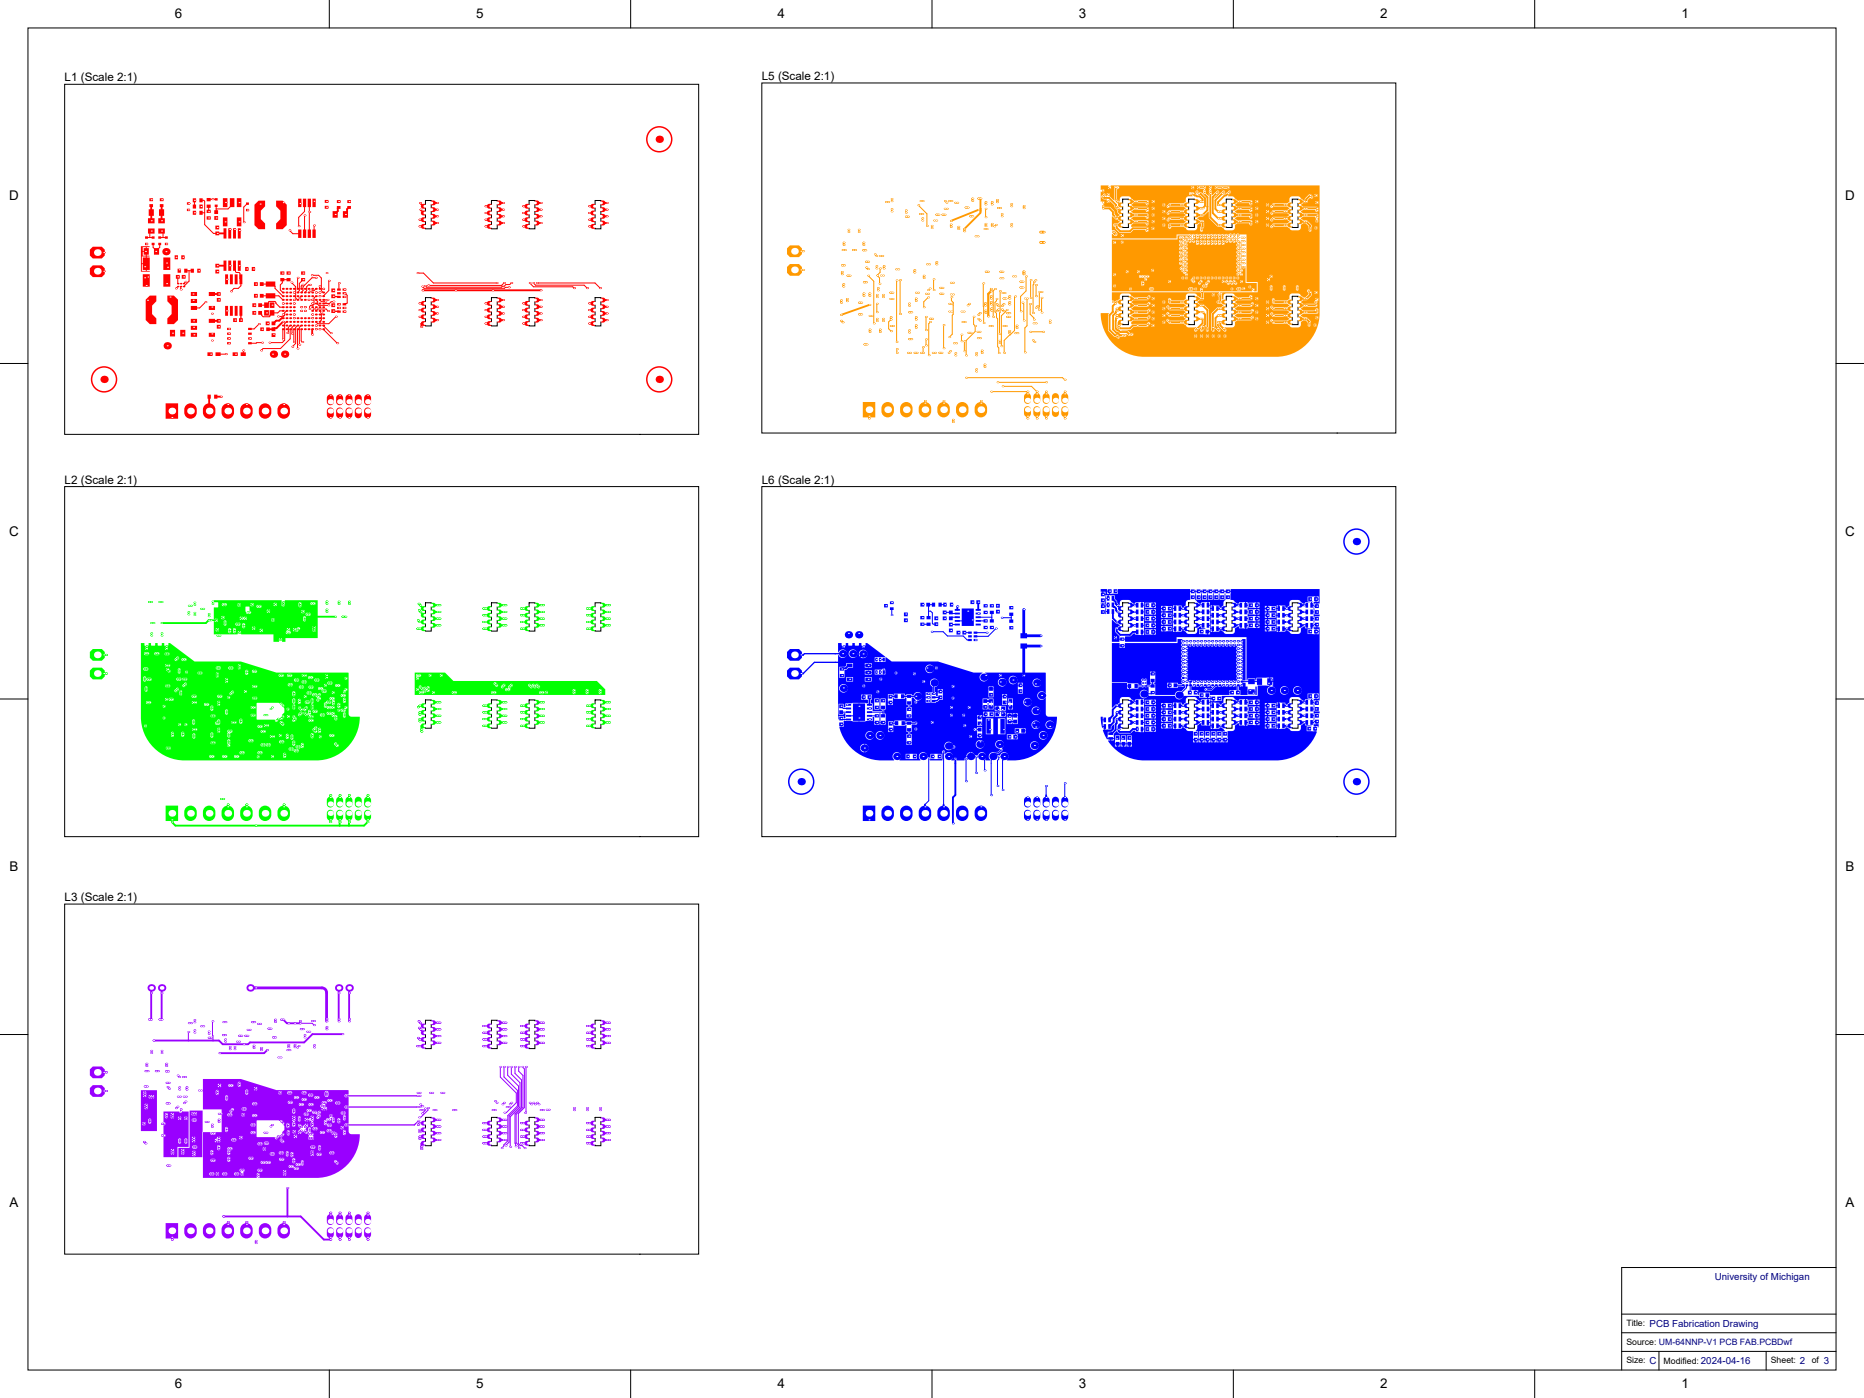
[picture p21: page 2]

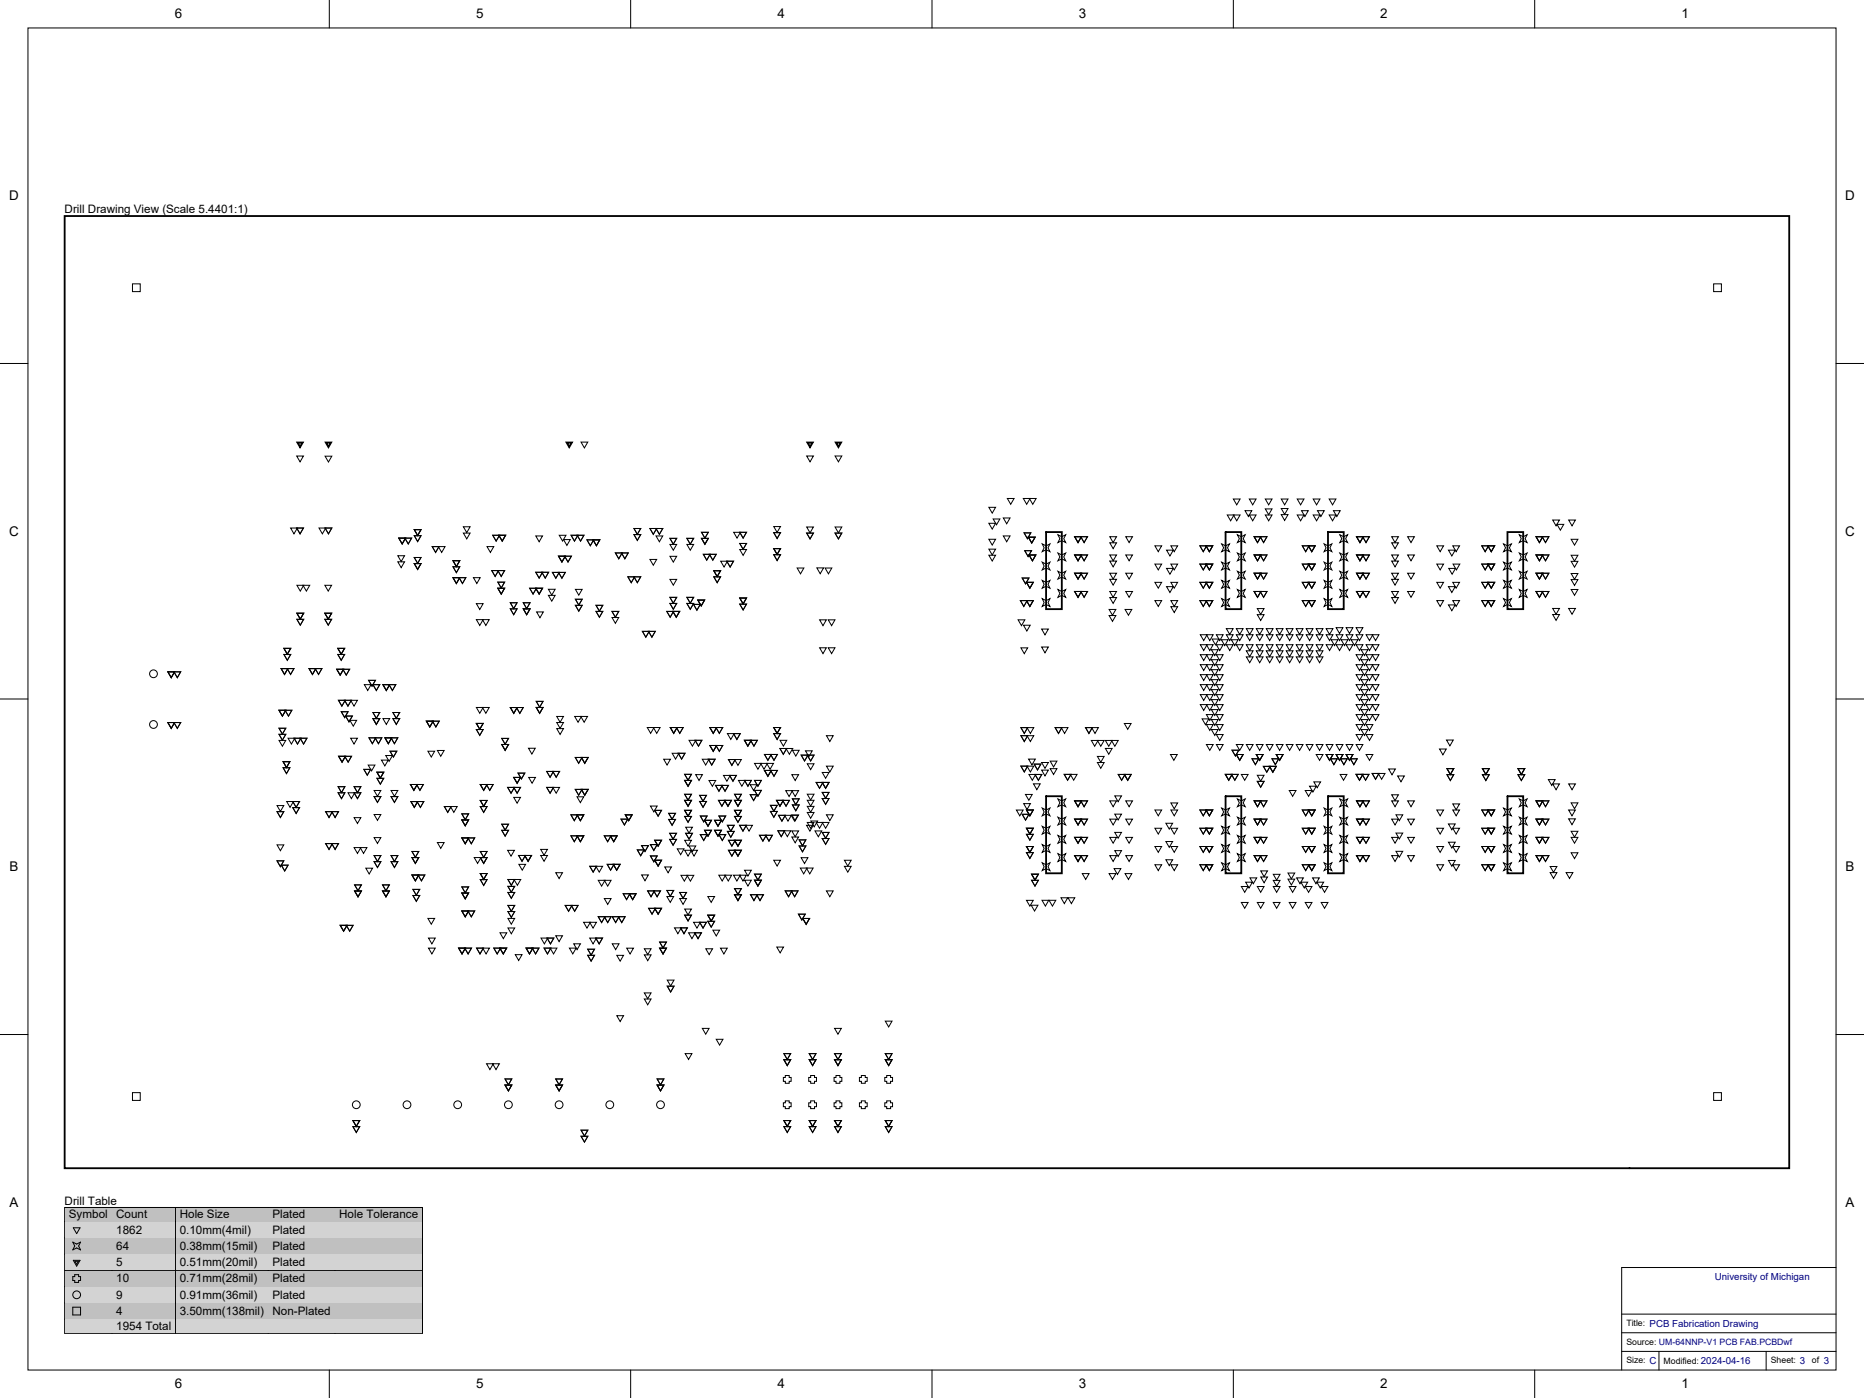
[picture p22: page 3]

Drill Drawing View (Scale 5.4401:1)

Symbol | Count | Hole Size | Plated | Hole Tolerance

1862 | 0.10mm(4mil) | Plated
64 | 0.38mm(15mil) | Plated
5 | 0.51mm(20mil) | Plated
10 | 0.71mm(28mil) | Plated

0.91mm(36mil) | Plated
3.50mm(138mil) | Non-Plated

1954 Total
