COSMIIC-Community/NOVA/(list of files, drawings)

Other design files:
64 Channel Recording Module/Design/PCB/NOVA V1/Altium Libraries/UM-64NNP.PcbLib
64 Channel Recording Module/Design/PCB/NOVA V1/Altium Libraries/UM-64NNP.SchLib
64 Channel Recording Module/Design/PCB/NOVA V1/UM-64NNP-V1 rev 0.18.PcbDoc
64 Channel Recording Module/Design/PCB/NOVA V1/UM-64NNP-V1 rev 0.18_norail.PcbDoc
64 Channel Recording Module/Design/PCB/NOVA V1/UM-64NNP-V1 Schematic rev 0.15.SchDoc
64 Channel Recording Module/Design/PCB/NOVA V1/UM-64NNP-V1.PrjPcb
