COSMIIC-Community/NOVA/64 Channel Recording Module/Design/PCB/Development Board V0.1/NOVA_DEV_V0-1.brd

## EAGLE design 64 Channel Recording Module/Design/PCB/Development Board V0.1/NOVA_DEV_V0-1.brd (2026-10-12)

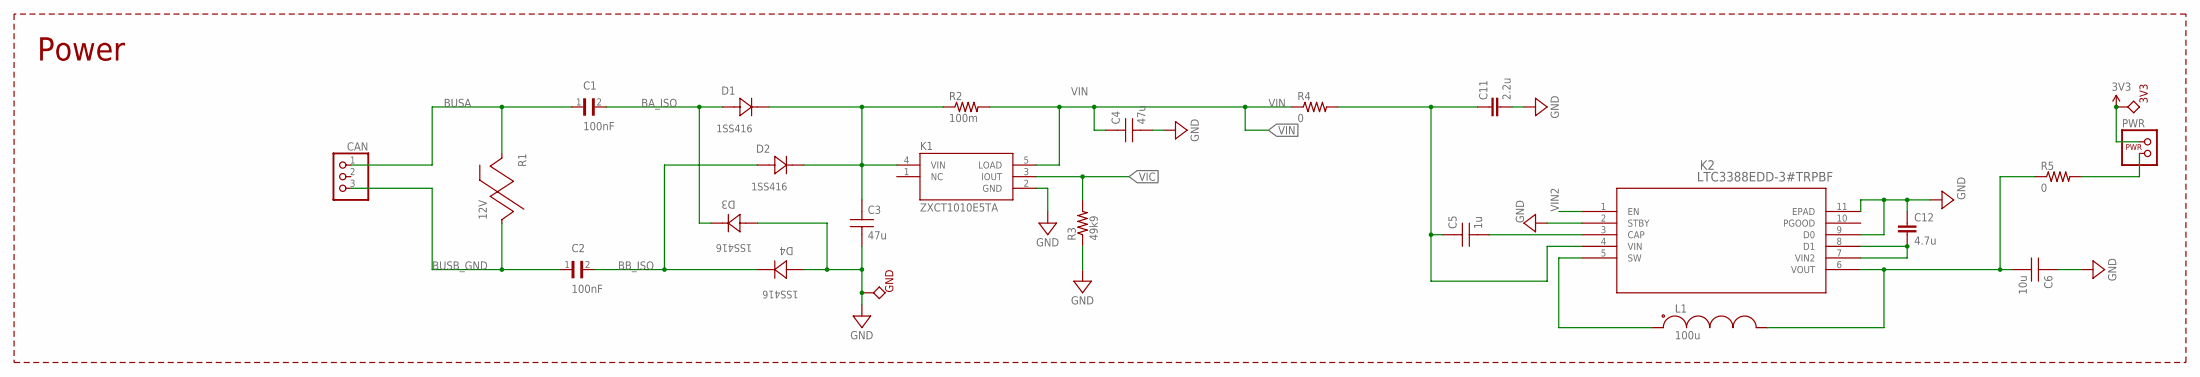
[picture p23: schematic NOVA_DEV_V0-1.sch, sheet 1]

Parts:
3V3: TPTP5001; TP5000OR5001
C1, C2: 100nF; CAPC1005X55N
C3, C4: 47u; C0603
C5: 1u; C0201
C6: 10u; C0603
C11: 2.2u; 0402
C12: 4.7u; 0402
CAN: PINHD-1X3; 1X03
D1, D2, D3, D4: 1SS416; SOD-923_TOS
GND: TPTP5001; TP5000OR5001
K1: ZXCT1010E5TA; SOT25
K2: LTC3388EDD-3#TRPBF; DFN-10_DD
L1: 100u; LPS4414
PWR: POWERJUMP; 1X04
R1: 12V; CG0603MLC
R2: 100m; R0201
R3: 49k9; 0201
R4, R5: 0; R0201

Connections:
3V3: 3V3.P$1, PWR.1, PWR.2 (1); also elsewhere on the board
BA_ISO: C1.2, D1.2 (ANODE), D3.1 (CATHODE)
BB_ISO: C2.2, D2.2 (ANODE), D4.1 (CATHODE)
BUSA: C1.1, CAN.1, R1.1; also elsewhere on the board
BUSB_GND: C2.1, CAN.3, R1.2; also elsewhere on the board
GND: C3.1, C4.1, C6.2, C11.2, C12.1, D3.2 (ANODE), D4.2 (ANODE), GND.P$1, K1.2 (GND), K2.2 (STBY), K2.9 (D0), K2.11 (EPAD), R3.1; also elsewhere on the board
unnamed: C5.2, C11.1, K2.4 (VIN), R4.2
unnamed: C12.2, K2.7 (VIN2), K2.8 (D1)
unnamed: C6.1, K2.6 (VOUT), L1.P$2, R5.1
unnamed: C5.1, K2.3 (CAP)
unnamed: C3.2, D1.1 (CATHODE), D2.1 (CATHODE), K1.4 (VIN), R2.1
unnamed: K2.5 (SW), L1.P$1
unnamed: PWR.3 (2), PWR.4 (2), R5.2
VIC: K1.3 (IOUT), R3.2; also elsewhere on the board
VIN: C4.2, K1.5 (LOAD), R2.2, R4.1; also elsewhere on the board
VIN2: K2.1 (EN); also elsewhere on the board

Notes on the sheet:
Power

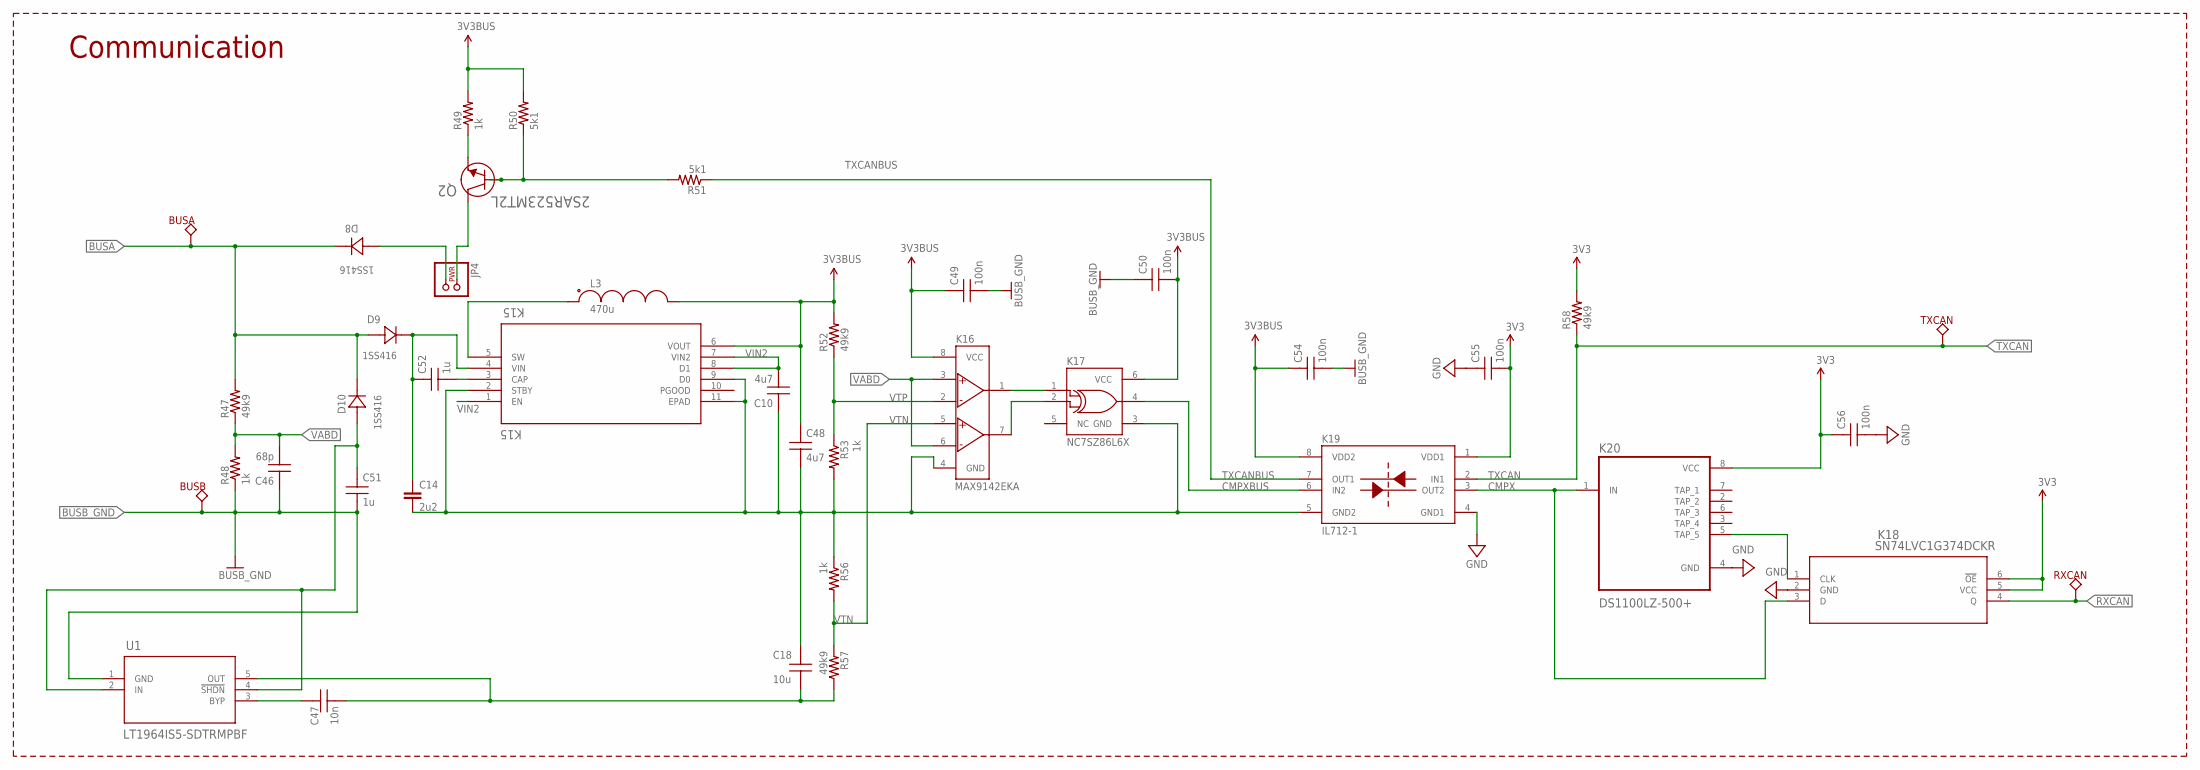
[picture p24: schematic NOVA_DEV_V0-1.sch, sheet 2]

Parts:
BUSA: TPTP5001; TP5000OR5001
BUSB: TPTP5001; TP5000OR5001
C10, C48: 4u7; C0402
C14: 2u2; 0402
C18: 10u; C0201
C46: 68p; C0201
C47: 10n; C0201
C49, C50, C54, C55, C56: 100n; C0201
C51, C52: 1u; C0201
D8, D9, D10: 1SS416; SOD-923_TOS
JP4: POWERJUMP; 1X04
K15: K15; DFN-10_DD
K16: MAX9142EKA; SOT23-8
K17: NC7SZ86L6X; MAC06A
K18: SN74LVC1G374DCKR; DCK6
K19: IL712-1; MSOP-8
K20: DS1100LZ-500+; SOIC127P600X175-8N
L3: 470u; CB2518
Q2: 2SAR523MT2L; TRANS_2SAR522M_ROM
R47, R52, R57, R58: 49k9; 0201
R48, R49, R53, R56: 1k; 0201
R50, R51: 5k1; 0201
RXCAN: TPTP5001; TP5000OR5001
TXCAN: TPTP5001; TP5000OR5001
U1: LT1964IS5-SDTRMPBF; TSOT23-5_S5_ADI

Connections:
3V3: C55.1, C56.2, K18.5 (VCC), K18.6 (!OE), K19.1 (VDD1), K20.8 (VCC), R58.2; also elsewhere on the board
3V3BUS: C48.2, C49.2, C50.1, C54.2, K15.6 (VOUT), K16.8 (VCC), K17.6 (VCC), K19.8 (VDD2), L3.2, R49.2, R50.2, R52.2
3V3BUS2: JP4.1, JP4.2 (1), Q2.1 (COLLECTOR)
BUSA: BUSA.P$1, D8.1 (CATHODE), D9.2 (ANODE), D10.1 (CATHODE), R47.2; also elsewhere on the board
BUSB_GND: BUSB.P$1, C46.2, C49.1, C50.2, C51.1, C54.1, R48.1, U1.1 (GND); also elsewhere on the board
CMPX: K18.3 (D), K19.3 (OUT2), K20.1 (IN)
CMPXBUS: K17.4 (Y), K19.6 (IN2)
GND: C55.2, C56.1, K18.2 (GND), K19.4 (GND1), K20.4 (GND); also elsewhere on the board
unnamed: K15.5 (SW), L3.1
unnamed: C10.2, C14.2, C18.2, C48.1, K15.2 (STBY), K15.9 (D0), K15.11 (EPAD), K16.4 (GND), K17.3 (GND), K19.5 (GND2), R53.2, R56.1
unnamed: C52.1, K15.3 (CAP)
unnamed: K18.1 (CLK), K20.5 (TAP_5)
unnamed: Q2.3 (EMITTER), R49.1
unnamed: C47.2, U1.3 (BYP)
unnamed: C14.1, C52.2, D9.1 (CATHODE), K15.4 (VIN)
unnamed: C51.2, D10.2 (ANODE), U1.2 (IN), U1.4 (!SHDN)
unnamed: C18.1, C47.1, R57.1, U1.5 (OUT)
unnamed: Q2.2 (BASE), R50.1, R51.2
unnamed: K16.1 (OUT1), K17.1 (A)
unnamed: K16.7 (OUT2), K17.2 (B)
unnamed: D8.2 (ANODE), JP4.3 (2), JP4.4 (2)
RXCAN: K18.4 (Q), RXCAN.P$1; also elsewhere on the board
TXCAN: K19.2 (IN1), R58.1, TXCAN.P$1; also elsewhere on the board
TXCANBUS: K19.7 (OUT1), R51.1
VABD: C46.1, K16.3 (+IN1), K16.6 (-IN2), R47.1, R48.2
VIN2: C10.1, K15.1 (EN), K15.7 (VIN2), K15.8 (D1); also elsewhere on the board
VTN: K16.5 (+IN2), R56.2, R57.2
VTP: K16.2 (-IN1), R52.1, R53.1

Notes on the sheet:
Communication

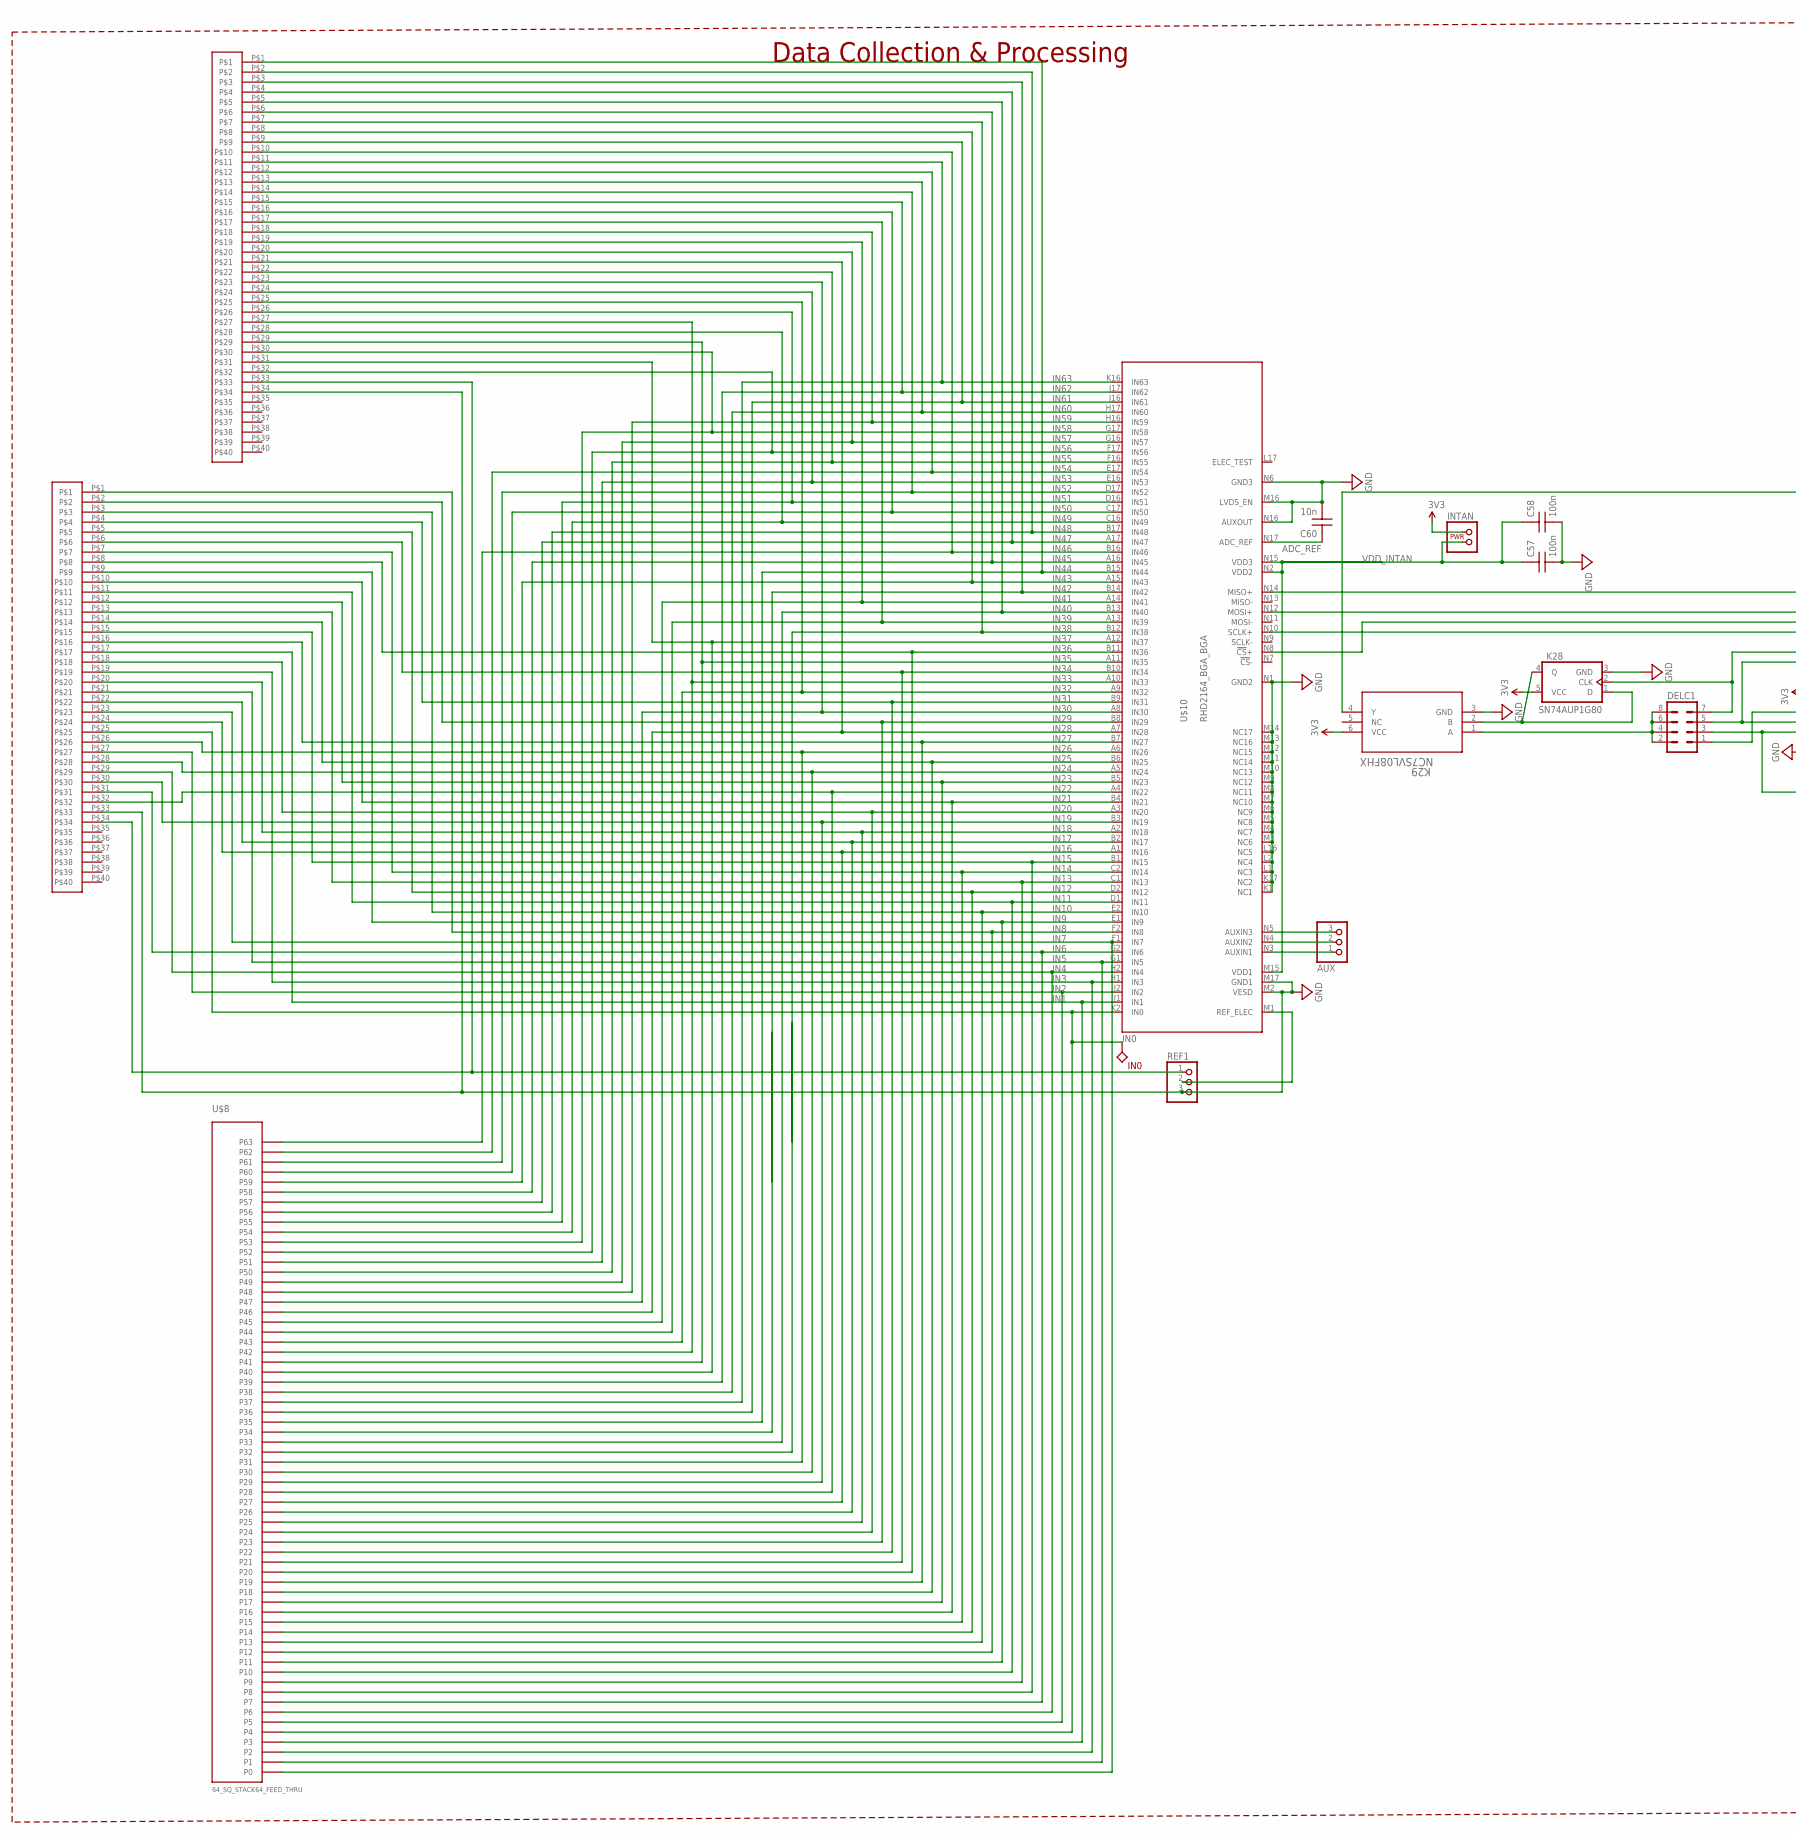
[picture p25: schematic NOVA_DEV_V0-1.sch, sheet 3, part in row 1, column 1]

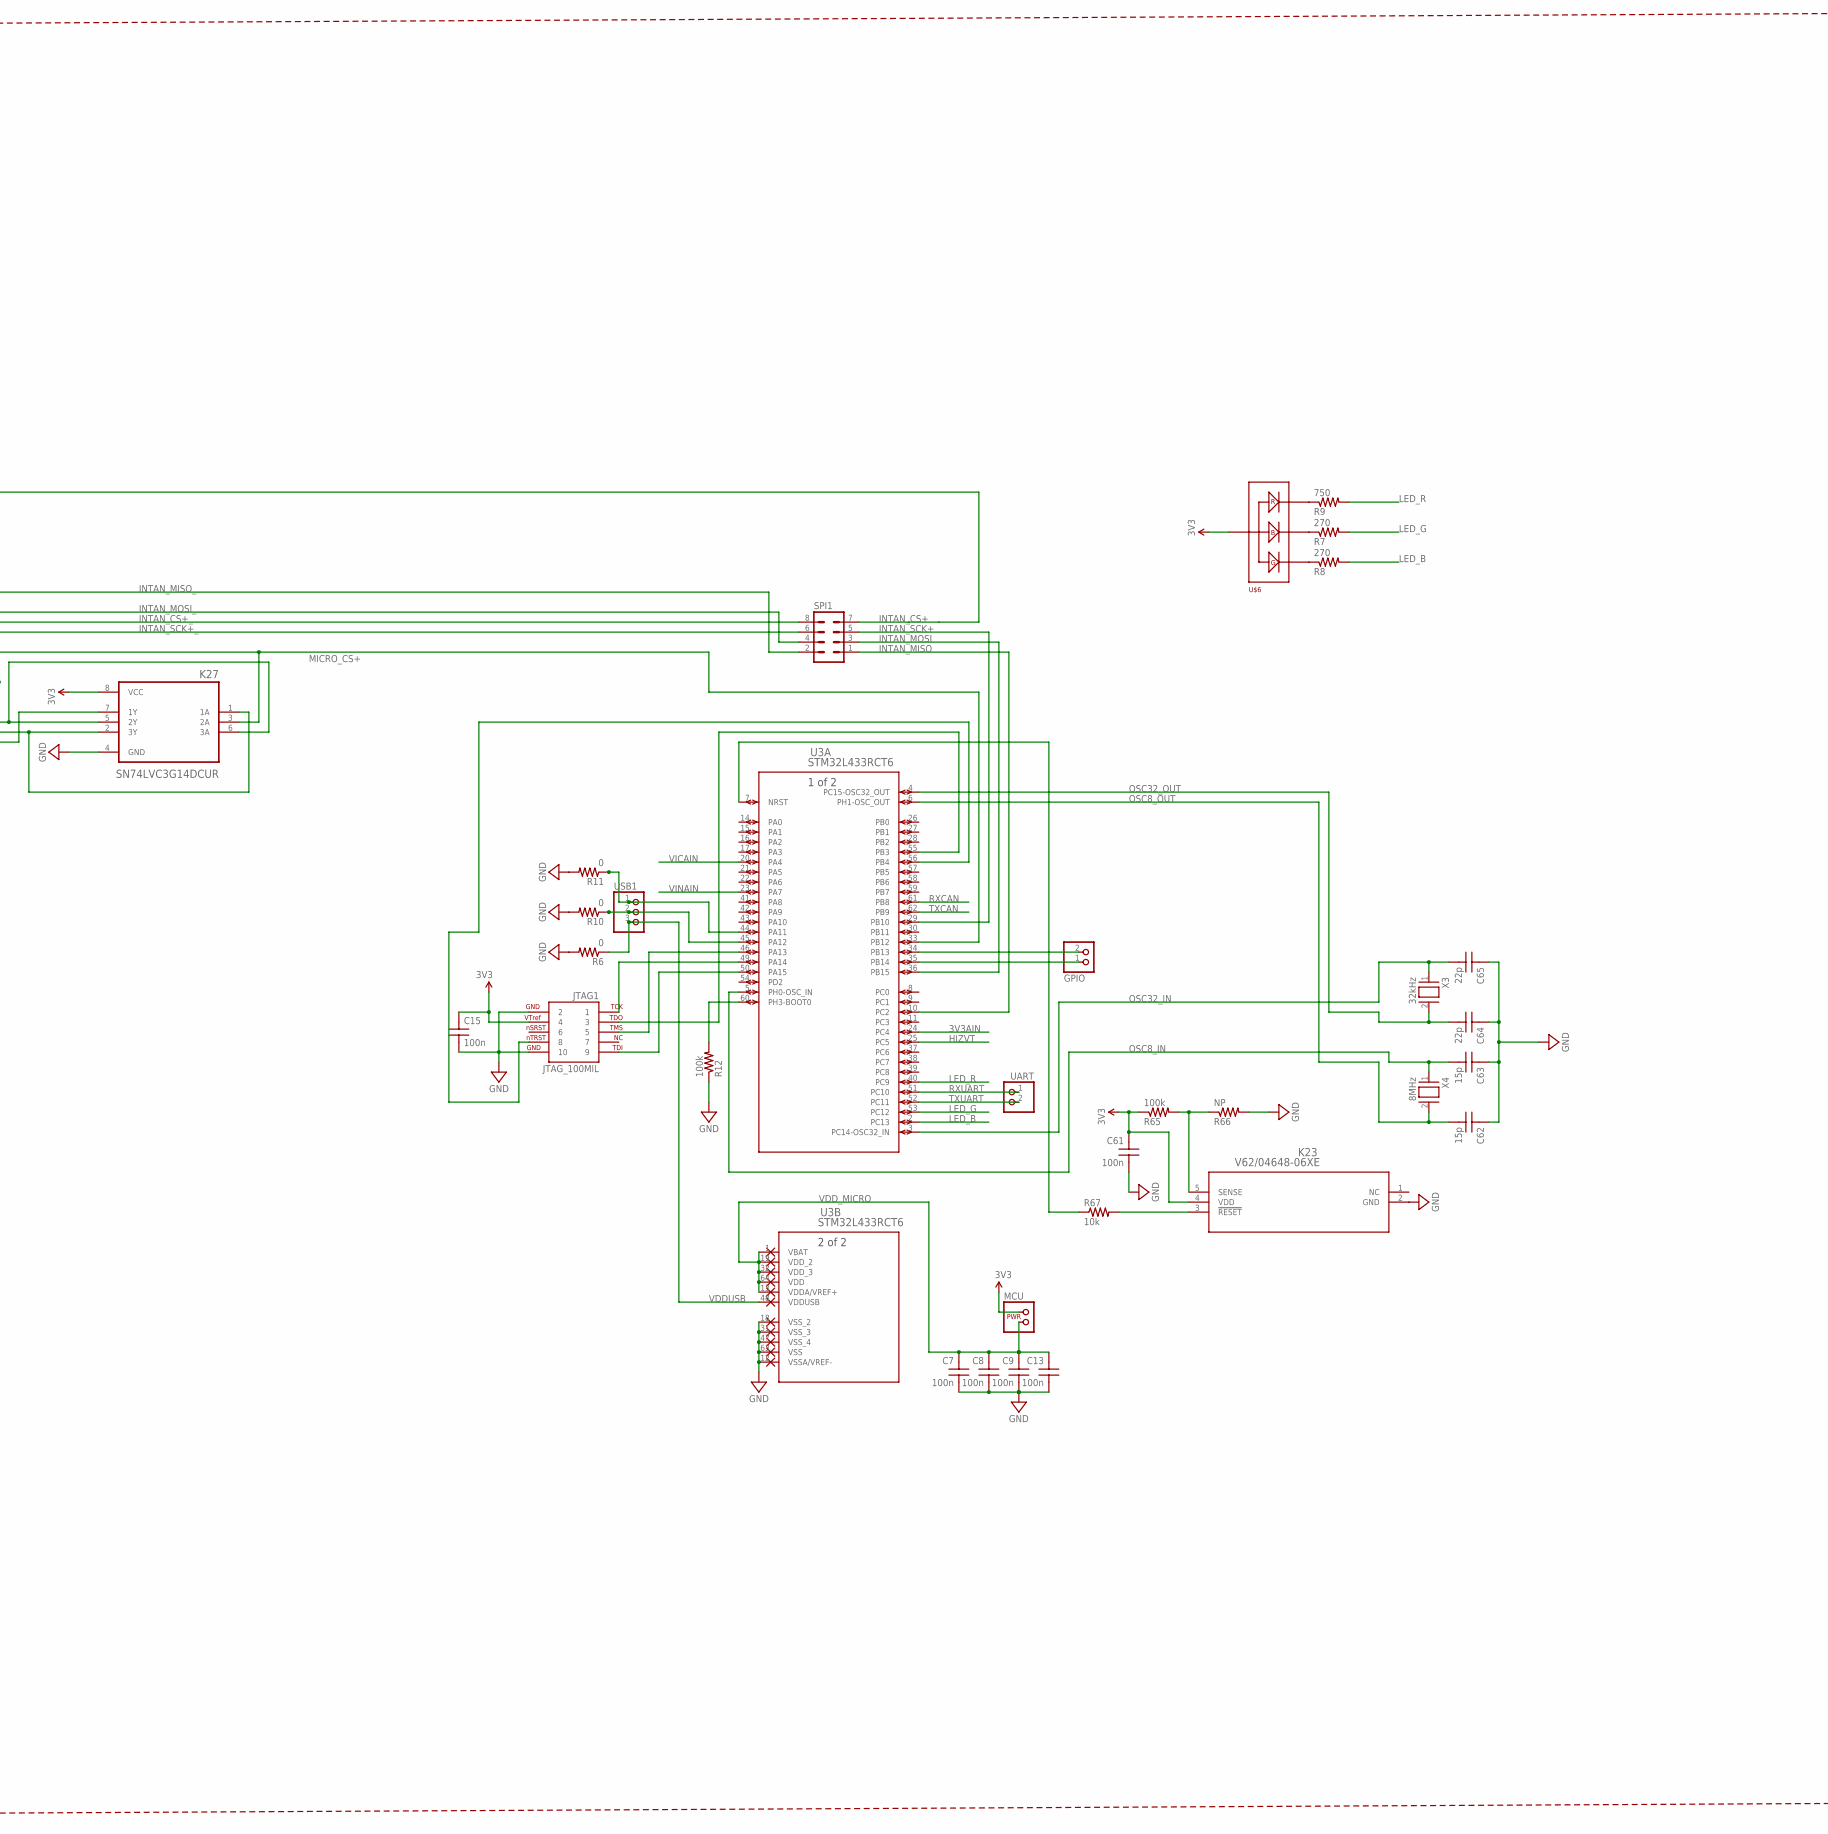
[picture p26: schematic NOVA_DEV_V0-1.sch, sheet 3, part in row 1, column 2]

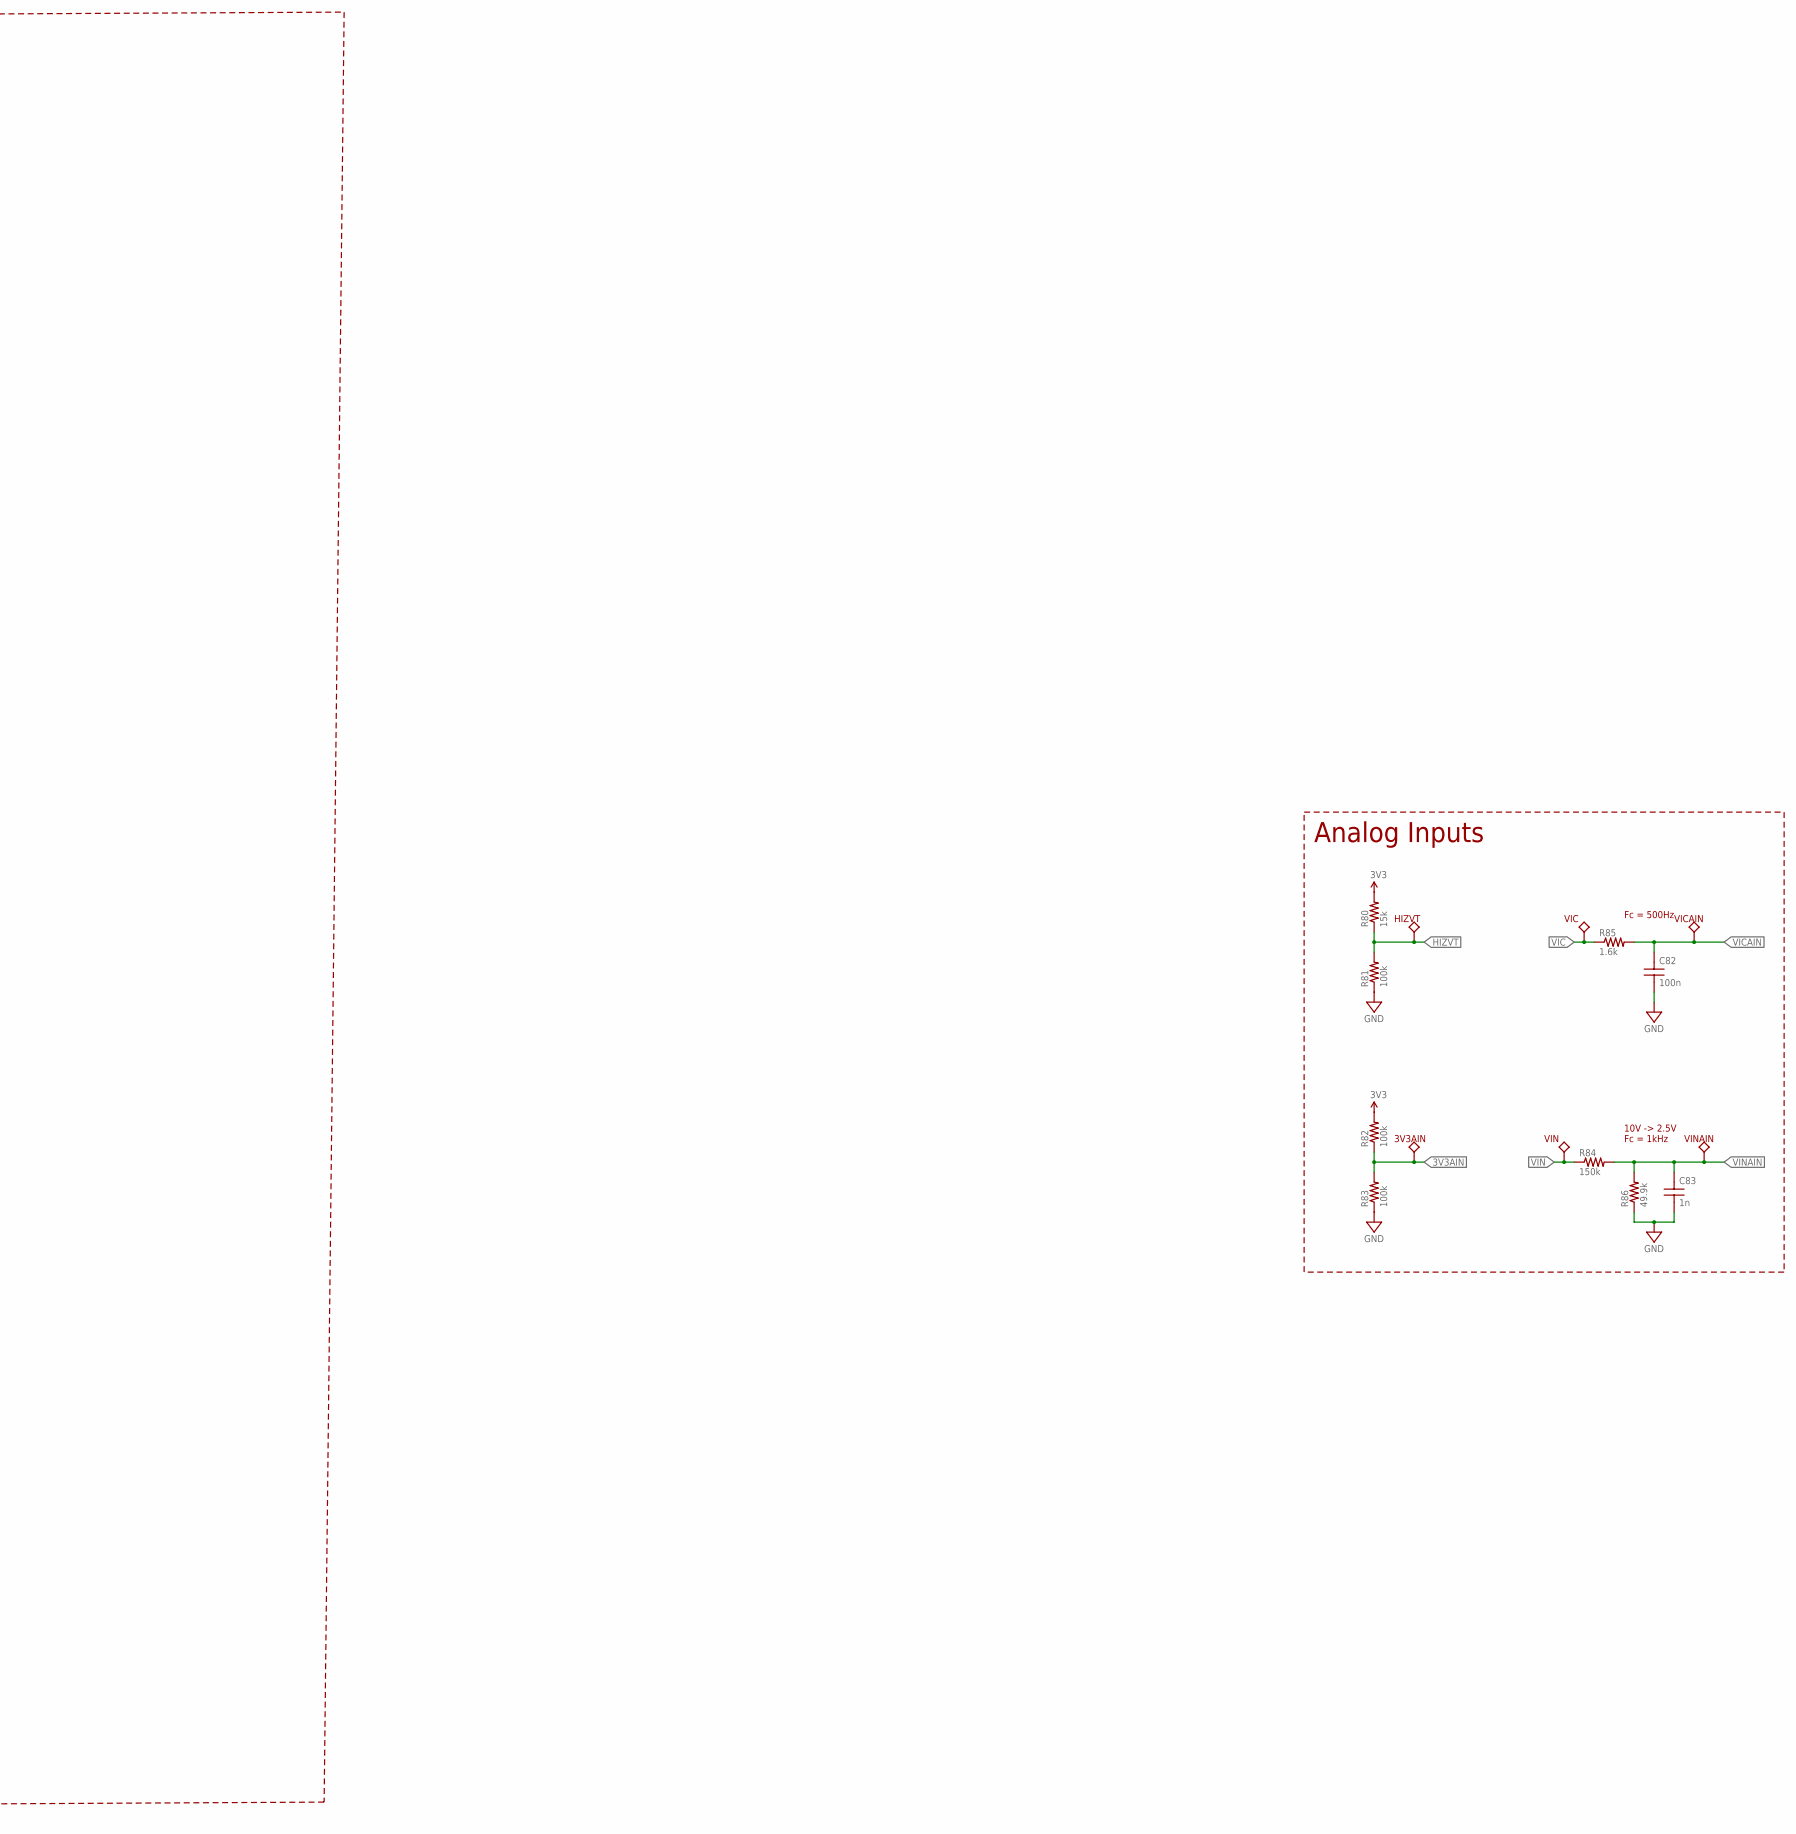
[picture p27: schematic NOVA_DEV_V0-1.sch, sheet 3, part in row 1, column 3]

Parts:
3V3AIN: TPTP5001; TP5000OR5001
AUX: PINHD-1X3; 1X03
C7, C8, C9, C13, C15, C57, C58, C61, C82: 100n; C0201
C60: 10n; C0201
C62, C63: 15p; C0402
C64, C65: 22p; C0402
C83: 1n; C0201
DELC1: MA04-2
GPIO: PINHD-1X2; 1X02
HIZVT: TPTP5001; TP5000OR5001
IN0: TPTP5001; TP5000OR5001
INTAN: POWERJUMP; 1X04
JTAG1: JTAG_100MIL; JTAG-10
K23: V62/04648-06XE; DCK5
K27: SN74LVC3G14DCUR; SOP50P310X90-8N
K28: SN74AUP1G80; SOT23-5
K29: NC7SVL08FHX; MICROPAK2-6_1X1_ONS
MCU: POWERJUMP; 1X04
R6, R10, R11: 0; R0201
R7, R8: 270; R0201
R9: 750; R0201
R12, R65, R81, R82, R83: 100k; R0201
R66: NP; R0201
R67: 10k; R0201
R80: 15k; R0201
R84: 150k; R0201
R85: 1.6k; R0201
R86: 49.9k; 0201
REF1: PINHD-1X3; 1X03
SPI1: MA04-2
U3: STM32L433RCT6; LQFP64-10X10MM
U$3, U$4: 40-PIN-SAMTEC; SAMTECSFH120-01-X-D-SM-LC
U$6: WINI_KINGBRIGHT_APHF1608LSEEQBDZGKC; WINI_4-SMD
U$8: 64_SQ_STACK64_FEED_THRU; 64_FEED_THRU
U$10: RHD2164_BGA_BGA; BGA104_9X7
UART: PINHD-1X2; 1X02
USB1: PINHD-1X3; 1X03
VIC: TPTP5001; TP5000OR5001
VICAIN: TPTP5001; TP5000OR5001
VIN: TPTP5001; TP5000OR5001
VINAIN: TPTP5001; TP5000OR5001
X3: 32kHz; ABS07
X4: 8MHz; NX5032GA

Connections:
3V3: C15.2, C61.2, INTAN.1, INTAN.2 (1), JTAG1.4, K23.4 (VDD), K27.8 (VCC), K28.5 (VCC), K29.6 (VCC), MCU.1, MCU.2 (1), R65.1, R80.2, R82.2, U$6.V+; also elsewhere on the board
3V3AIN: 3V3AIN.P$1, R82.1, R83.2, U3.24 (PC4)
ADC_REF: C60.2, U$10.N17 (ADC_REF)
GND: C7.1, C8.1, C9.1, C13.1, C15.1, C57.1, C58.1, C60.1, C61.1, C62.2, C63.2, C64.2, C65.2, C82.1, C83.1, JTAG1.2, JTAG1.10, K23.2 (GND), K27.4 (GND), K28.3 (GND), K29.3 (GND), R6.2, R10.2, R11.2, R12.1, R66.2, R81.1, R83.1, R86.1, REF1.3, U3.12 (VSSA/VREF-), U3.18 (VSS_2), U3.31 (VSS_3), U3.47 (VSS_4), U3.63 (VSS), U$3.P$34, U$4.P$33, U$10.K1 (NC1), U$10.K17 (NC2), U$10.L1 (NC3), U$10.L2 (NC4), U$10.L16 (NC5), U$10.M2 (VESD), U$10.M3 (NC6), U$10.M4 (NC7), U$10.M5 (NC8), U$10.M6 (NC9), U$10.M7 (NC10), U$10.M8 (NC11), U$10.M9 (NC12), U$10.M10 (NC13), U$10.M11 (NC14), U$10.M12 (NC15), U$10.M13 (NC16), U$10.M14 (NC17), U$10.M16 (LVDS_EN), U$10.M17 (GND1), U$10.N1 (GND2), U$10.N6 (GND3), U$10.N16 (AUXOUT); also elsewhere on the board
HIZVT: HIZVT.P$1, R80.1, R81.2, U3.25 (PC5)
IN0: IN0.P$1, U$4.P$25, U$8.P$5 (P4), U$10.K2 (IN0)
IN1: U$4.P$17, U$8.P$4 (P3), U$10.J1 (IN1)
IN2: U$4.P$27, U$8.P$6 (P5), U$10.J2 (IN2)
IN3: U$4.P$19, U$8.P$3 (P2), U$10.H1 (IN3)
IN4: U$4.P$29, U$8.P$7 (P6), U$10.H2 (IN4)
IN5: U$4.P$21, U$8.P$2 (P1), U$10.G1 (IN5)
IN6: U$4.P$31, U$8.P$8 (P7), U$10.G2 (IN6)
IN7: U$4.P$23, U$8.P$1 (P0), U$10.F1 (IN7)
IN8: U$4.P$1, U$8.P$13 (P12), U$10.F2 (IN8)
IN9: U$4.P$9, U$8.P$12 (P11), U$10.E1 (IN9)
IN10: U$4.P$3, U$8.P$14 (P13), U$10.E2 (IN10)
IN11: U$4.P$11, U$8.P$11 (P10), U$10.D1 (IN11)
IN12: U$4.P$5, U$8.P$15 (P14), U$10.D2 (IN12)
IN13: U$4.P$13, U$8.P$10 (P9), U$10.C1 (IN13)
IN14: U$4.P$7, U$8.P$16 (P15), U$10.C2 (IN14)
IN15: U$4.P$15, U$8.P$9 (P8), U$10.B1 (IN15)
IN16: U$4.P$24, U$8.P$28 (P27), U$10.A1 (IN16)
IN17: U$4.P$22, U$8.P$27 (P26), U$10.B2 (IN17)
IN18: U$4.P$20, U$8.P$26 (P25), U$10.A2 (IN18)
IN19: U$4.P$30, U$8.P$30 (P29), U$10.B3 (IN19)
IN20: U$4.P$18, U$8.P$25 (P24), U$10.A3 (IN20)
IN21: U$4.P$10, U$8.P$17 (P16), U$10.B4 (IN21)
IN22: U$4.P$32, U$8.P$29 (P28), U$10.A4 (IN22)
IN23: U$4.P$12, U$8.P$18 (P17), U$10.B5 (IN23)
IN24: U$4.P$28, U$8.P$31 (P30), U$10.A5 (IN24)
IN25: U$4.P$14, U$8.P$19 (P18), U$10.B6 (IN25)
IN26: U$4.P$26, U$8.P$32 (P31), U$10.A6 (IN26)
IN27: U$4.P$16, U$8.P$20 (P19), U$10.B7 (IN27)
IN28: U$3.P$21, U$8.P$47 (P46), U$10.A7 (IN28)
IN29: U$4.P$2, U$8.P$24 (P23), U$10.B8 (IN29)
IN30: U$3.P$23, U$8.P$48 (P47), U$10.A8 (IN30)
IN31: U$4.P$4, U$8.P$23 (P22), U$10.B9 (IN31)
IN32: U$3.P$25, U$8.P$44 (P43), U$10.A9 (IN32)
IN33: U$3.P$27, U$8.P$43 (P42), U$10.A10 (IN33)
IN34: U$4.P$6, U$8.P$22 (P21), U$10.B10 (IN34)
IN35: U$3.P$29, U$8.P$42 (P41), U$10.A11 (IN35)
IN36: U$4.P$8, U$8.P$21 (P20), U$10.B11 (IN36)
IN37: U$3.P$31, U$8.P$41 (P40), U$10.A12 (IN37)
IN38: U$3.P$7, U$8.P$33 (P32), U$10.B12 (IN38)
IN39: U$3.P$17, U$8.P$45 (P44), U$10.A13 (IN39)
IN40: U$3.P$5, U$8.P$34 (P33), U$10.B13 (IN40)
IN41: U$3.P$19, U$8.P$46 (P45), U$10.A14 (IN41)
IN42: U$3.P$3, U$8.P$35 (P34), U$10.B14 (IN42)
IN43: U$3.P$8, U$8.P$60 (P59), U$10.A15 (IN43)
IN44: U$3.P$1, U$8.P$36 (P35), U$10.B15 (IN44)
IN45: U$3.P$6, U$8.P$59 (P58), U$10.A16 (IN45)
IN46: U$3.P$10, U$8.P$64 (P63), U$10.B16 (IN46)
IN47: U$3.P$4, U$8.P$58 (P57), U$10.A17 (IN47)
IN48: U$3.P$2, U$8.P$57 (P56), U$10.B17 (IN48)
IN49: U$3.P$28, U$8.P$55 (P54), U$10.C16 (IN49)
IN50: U$3.P$16, U$8.P$61 (P60), U$10.C17 (IN50)
IN51: U$3.P$26, U$8.P$56 (P55), U$10.D16 (IN51)
IN52: U$3.P$14, U$8.P$62 (P61), U$10.D17 (IN52)
IN53: U$3.P$24, U$8.P$52 (P51), U$10.E16 (IN53)
IN54: U$3.P$12, U$8.P$63 (P62), U$10.E17 (IN54)
IN55: U$3.P$22, U$8.P$51 (P50), U$10.F16 (IN55)
IN56: U$3.P$32, U$8.P$53 (P52), U$10.F17 (IN56)
IN57: U$3.P$20, U$8.P$50 (P49), U$10.G16 (IN57)
IN58: U$3.P$30, U$8.P$54 (P53), U$10.G17 (IN58)
IN59: U$3.P$18, U$8.P$49 (P48), U$10.H16 (IN59)
IN60: U$3.P$13, U$8.P$39 (P38), U$10.H17 (IN60)
IN61: U$3.P$9, U$8.P$37 (P36), U$10.J16 (IN61)
IN62: U$3.P$15, U$8.P$40 (P39), U$10.J17 (IN62)
IN63: U$3.P$11, U$8.P$38 (P37), U$10.K16 (IN63)
INTAN_CS+: K29.4 (Y), SPI1.7
INTAN_CS+_: SPI1.8, U$10.N8 (!CS!+)
INTAN_MISO: SPI1.1, U3.10 (PC2)
INTAN_MISO_: SPI1.2, U$10.N14 (MISO+)
INTAN_MOSI: SPI1.3, U3.36 (PB15)
INTAN_MOSI_: SPI1.4, U$10.N12 (MOSI+)
INTAN_SCK+: SPI1.5, U3.29 (PB10)
INTAN_SCK+_: SPI1.6, U$10.N10 (SCLK+)
LED_B: R8.2, U3.2 (PC13)
LED_G: R7.2, U3.53 (PC12)
LED_R: R9.2, U3.40 (PC9)
MICRO_CS+: DELC1.7, K27.3 (2A), K28.2 (CLK), U3.33 (PB12)
unnamed: R67.1, U3.7 (NRST)
unnamed: AUX.1, U$10.N3 (AUXIN1)
unnamed: R12.2, U3.60 (PH3-BOOT0)
unnamed: AUX.2, U$10.N4 (AUXIN2)
unnamed: GPIO.2, U3.34 (PB13)
unnamed: DELC1.2, DELC1.4, DELC1.6, DELC1.8, K29.1 (A)
unnamed: DELC1.5, K27.5 (2Y), K27.6 (3A)
unnamed: GPIO.1, U3.35 (PB14)
unnamed: DELC1.3, K27.1 (1A), K27.2 (3Y)
unnamed: DELC1.1, K27.7 (1Y)
unnamed: AUX.3, U$10.N5 (AUXIN3)
unnamed: K23.3 (!RESET), R67.2
unnamed: REF1.1, U$3.P$33, U$4.P$34
unnamed: JTAG1.8, U3.56 (PB4)
unnamed: JTAG1.5, U3.46 (PA13)
unnamed: REF1.2, U$10.M1 (REF_ELEC)
unnamed: R7.1, U$6.B
unnamed: JTAG1.1, U3.49 (PA14)
unnamed: JTAG1.9, U3.50 (PA15)
unnamed: JTAG1.3, U3.55 (PB3)
unnamed: R8.1, U$6.G
unnamed: R9.1, U$6.R
unnamed: R11.1, U3.44 (PA11), USB1.1
unnamed: R10.1, U3.45 (PA12), USB1.2
unnamed: K23.5 (SENSE), R65.2, R66.1
unnamed: K28.1 (D), K28.4 (Q), K29.2 (B)
OSC8_IN: C63.1, U3.5 (PH0-OSC_IN), X4.1
OSC8_OUT: C62.1, U3.6 (PH1-OSC_OUT), X4.2
OSC32_IN: C65.1, U3.3 (PC14-OSC32_IN), X3.1
OSC32_OUT: C64.1, U3.4 (PC15-OSC32_OUT), X3.2
RXCAN: U3.61 (PB8); also elsewhere on the board
RXUART: U3.51 (PC10), UART.1
TXCAN: U3.62 (PB9); also elsewhere on the board
TXUART: U3.52 (PC11), UART.2
VDDUSB: R6.1, U3.48 (VDDUSB), USB1.3
VDD_INTAN: C57.2, C58.2, INTAN.3 (2), INTAN.4 (2), U$10.M15 (VDD1), U$10.N2 (VDD2), U$10.N15 (VDD3)
VDD_MICRO: C7.2, C8.2, C9.2, C13.2, MCU.3 (2), MCU.4 (2), U3.1 (VBAT), U3.13 (VDDA/VREF+), U3.19 (VDD_2), U3.32 (VDD_3), U3.64 (VDD)
VIC: R85.1, VIC.P$1; also elsewhere on the board
VICAIN: C82.2, R85.2, U3.20 (PA4), VICAIN.P$1
VIN: R84.1, VIN.P$1; also elsewhere on the board
VINAIN: C83.2, R84.2, R86.2, U3.23 (PA7), VINAIN.P$1

Notes on the sheet:
Data Collection & Processing
Analog Inputs
Fc = 500Hz
10V -> 2.5V Fc = 1kHz

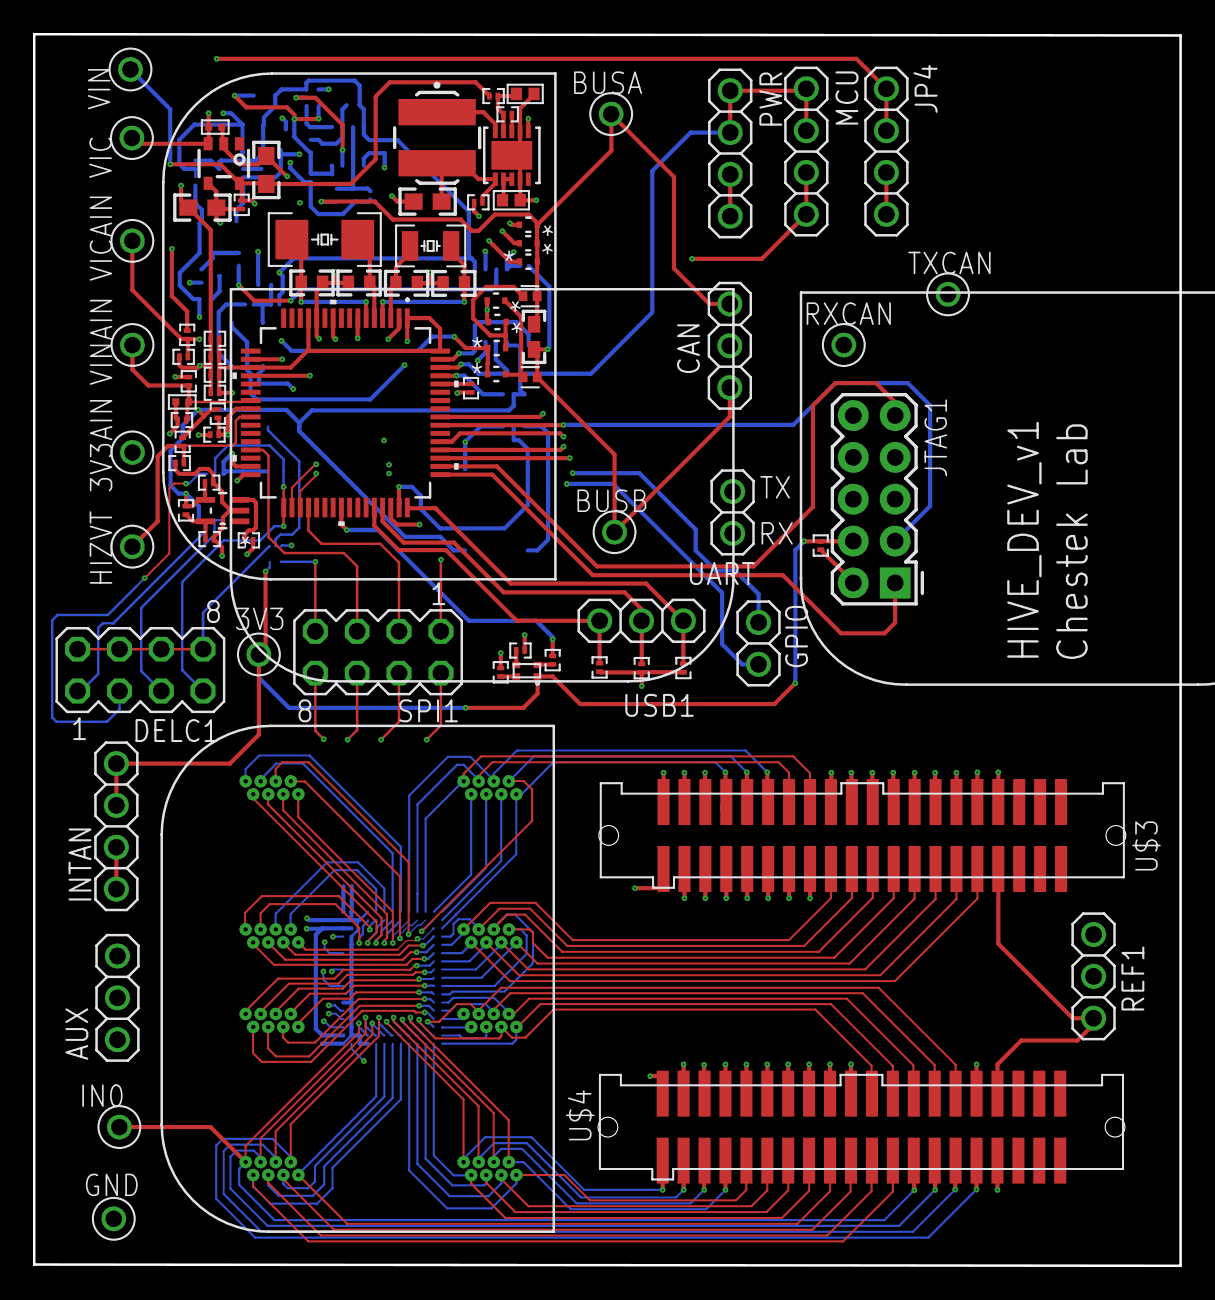
[picture p28: board NOVA_DEV_V0-1.brd from above]

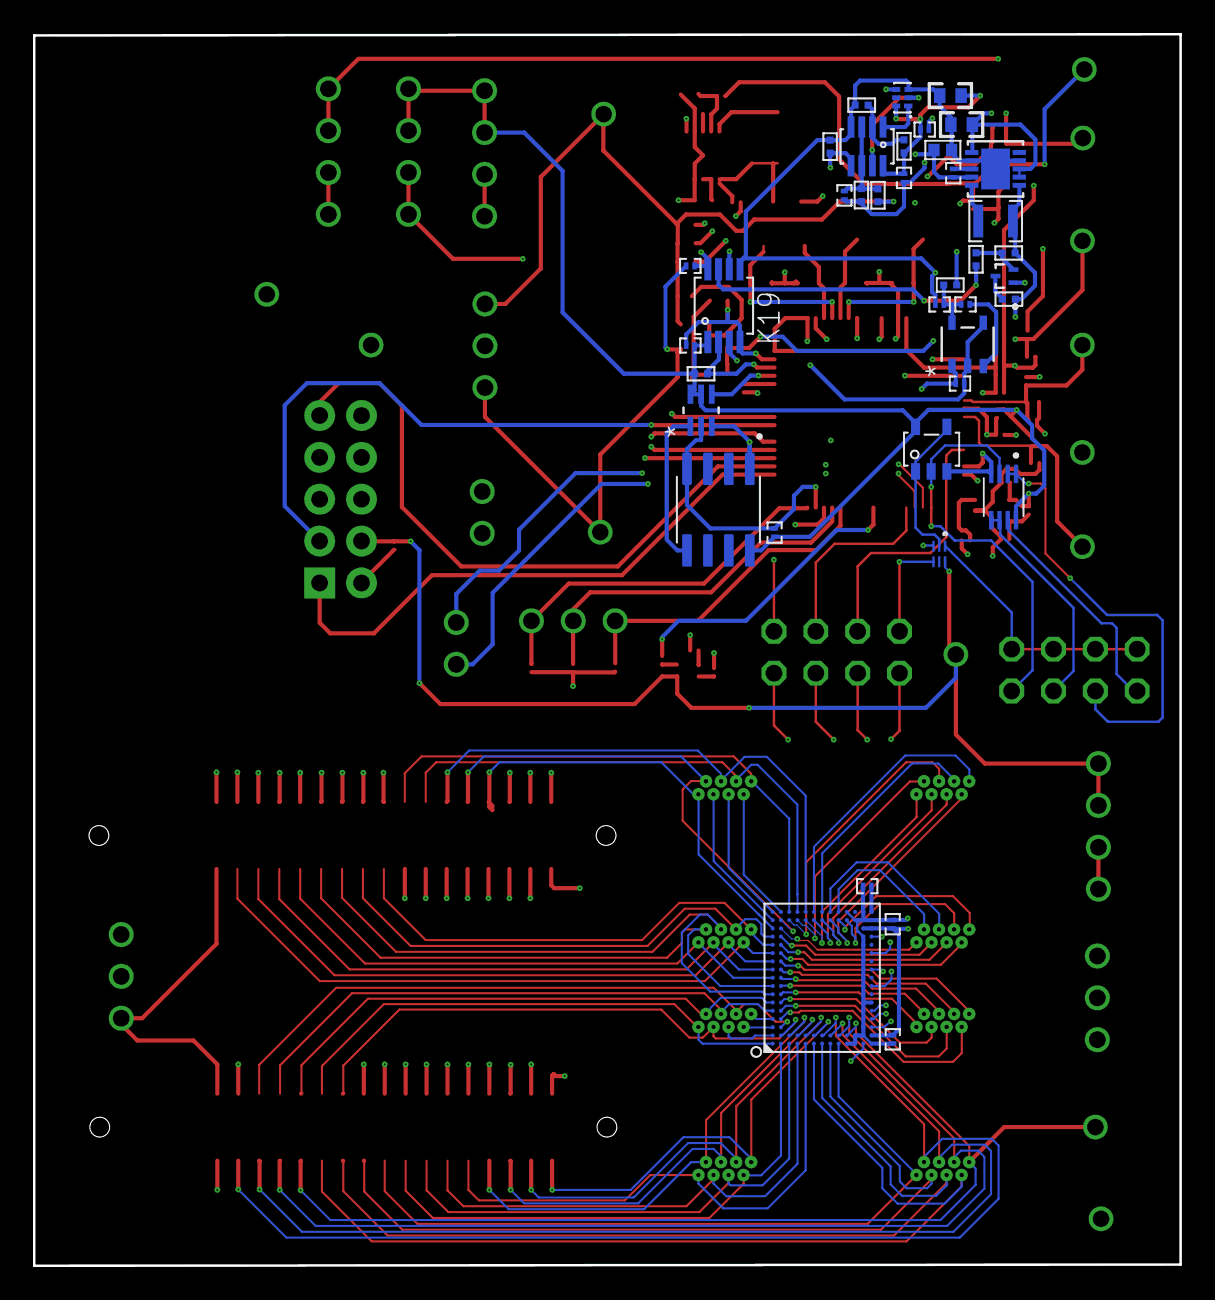
[picture p29: board NOVA_DEV_V0-1.brd from below]

Board: 4 copper layers, 69.6 x 74.8 mm, 125 parts (40 on the bottom side), 155 nets.
