COSMIIC-Community/NOVA/64 Channel Recording Module/Design/Firmware/Core/Src/main.c

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
/* Includes ------------------------------------------------------------------*/
#include "main.h"

/* USER CODE BEGIN Includes */
#include "eedata.h"
#include "app.h"
#include "flash_config.h"
#include "serial_interface.h"
#include "sampling.h"
/* USER CODE END Includes */


FDCAN_HandleTypeDef hfdcan1;

SPI_HandleTypeDef hspi1;
SPI_HandleTypeDef hspi2;
SPI_HandleTypeDef hspi3;
DMA_HandleTypeDef handle_GPDMA1_Channel9;
DMA_HandleTypeDef handle_GPDMA1_Channel11;
DMA_HandleTypeDef handle_GPDMA1_Channel10;

TIM_HandleTypeDef htim6;

/* USER CODE BEGIN PV */
DMA_HandleTypeDef handle_GPDMA1_Channel8;
FDCAN_FilterTypeDef   sFilterConfig;
FDCAN_RxHeaderTypeDef RxHeader;
FDCAN_TxHeaderTypeDef TxHeader;
FDCAN_TxHeaderTypeDef TxHeaderSDO;
FDCAN_TxHeaderTypeDef TxHeaderPDO;
FDCAN_TxHeaderTypeDef TxHeaderScan;

uint8_t RxData[8];
uint8_t TxData[8];
uint8_t TxDataSDO[8];
uint8_t TxDataPDO[8];
uint8_t TxDataScan[8];


UNS16 blink = 0;
UNS8 lastRequestedAddress = 0;

// Transmission control state
static UNS8 transmission_active = 0;  // 0 = stopped, 1 = running

/* USER CODE END PV */

void SystemClock_Config(void);
static void SystemPower_Config(void);
static void MX_GPIO_Init(void);
static void MX_GPDMA1_Init(void);
static void MX_SPI2_Init(void);
static void MX_SPI1_Init(void);
static void MX_SPI3_Init(void);
static void MX_ICACHE_Init(void);
static void MX_FDCAN1_Init(void);
static void MX_TIM6_Init(void);
/* USER CODE BEGIN PFP */
void initNodeIDSerialNumber( void );
void ReadMemory( void );
UNS8 ReadLocalFlashMemory(void);
UNS8 ReadEEProm(void);
UNS8 WriteEEProm ( void );


/* USER CODE END PFP */

/* USER CODE BEGIN 0 */

/**
  * @brief Callback that runs at the beginning of timer execution
  */
void start_callback(CO_Data* d, UNS32 id)
{
	setState(&ObjDict_Data, Waiting);
}

/**
  * @brief  Initializes node ID and serial number data in the object dictionary
  */
void initNodeIDSerialNumber(void)
{
	UNS8 node = *(uint8_t*)(NODE_NB_ADDR); // Config data lives in the last page of flash
	if(node > 0 && node <= 0x7F)
	  Status_NodeId = node;

	setNodeId(&ObjDict_Data, Status_NodeId);

	ObjDict_obj1018_Serial_Number = *(uint8_t*)(SERIAL_NB_ADDR) << 8 | *(uint8_t*)(SERIAL_NB_ADDR + 1);
	ObjDict_obj1018_Product_Code =  *(uint8_t*)(PRODUCT_CODE_ADDR);

	HAL_Delay(START_DELAY_MS * (Status_NodeId - 1));
}


/* USER CODE END 0 */

/**
  * @brief  The application entry point.
  * @retval int
  */
int main(void)
{

  /* MCU Configuration--------------------------------------------------------*/

  /* Reset of all peripherals, Initializes the Flash interface and the Systick. */
  HAL_Init();

  /* USER CODE BEGIN Init */
//  if (CheckRestoreFlag())
//  {
//	  //Load custom settings from EEPROM into the OD
//	  RestoreValues();
//  }
//  else
//  {
//	  //Use default settings from OD rather than what is stored in EEPROM
//	  //Then, overwrite EEPROM with these default settings
//	  SaveValues();
//  }
  /* USER CODE END Init */

  /* Configure the System Power */
  SystemPower_Config();

  /* Configure the system clock */
  SystemClock_Config();

  /* USER CODE BEGIN SysInit */
//  initNodeIDSerialNumber();
  /* USER CODE END SysInit */

  /* Initialize all configured peripherals */
  MX_GPIO_Init();
  MX_GPDMA1_Init();
  MX_SPI2_Init();
  MX_SPI1_Init();
  MX_SPI3_Init();
  MX_ICACHE_Init();
  // MX_FDCAN1_Init();
  // MX_TIM6_Init();
  /* USER CODE BEGIN 2 */

//  initDiagnostics();
  initAppTask();

  /* USER CODE END 2 */

  /* Infinite loop */
  /* USER CODE BEGIN WHILE */
  while (1)
  {
//	// Check for USART command to start/stop data transmission
//	UNS8 command_state = check_command_status();
//
//	// Handle state transitions
//	if (command_state && !transmission_active)
//	{
//		// START command received - begin data acquisition
//		transmission_active = 1;
//		restart_data_acquisition();
//	}
//	else if (!command_state && transmission_active)
//	{
//		// STOP command received - halt data acquisition
//		transmission_active = 0;
//		stop_data_acquisition();
//	}

	// Only run application task if transmission is active
//	if (transmission_active)
//	{
		updateAppTask();
//	}

//	Status_TestValue++;
//
//	if(blink++ > 350){
//	  if(getState(&ObjDict_Data) == Waiting)
//	  {
//		  ReadMemory();
//	  }
//	  blink = 0;
//	  //Turn off heartbeat LED
//	  //HAL_GPIO_WritePin(PC4_LED_GPIO_Port, PC4_LED_Pin, 1);
//	}
//	else if(blink > 300)
//	{
//	  //Turn off heartbeat LED
//	  //HAL_GPIO_WritePin(PC4_LED_GPIO_Port, PC4_LED_Pin, 0);
//	}
//
//	HAL_PWR_EnterSLEEPMode(PWR_MAINREGULATOR_ON, PWR_SLEEPENTRY_WFI);

    /* USER CODE END WHILE */

    /* USER CODE BEGIN 3 */
  }
  /* USER CODE END 3 */
}

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
/* USER CODE BEGIN 4 */
/**
 * @brief Command processor to let CE read various memory locations
 * @param none
 */
void ReadMemory(void)
{
	// clear status
	if (memorySelect > 0 )
	  statusByteMemory = 0;

	if (memorySelect == 1)
	  statusByteMemory = ReadLocalFlashMemory();
	else if (memorySelect == 4)
	  statusByteMemory = ReadEEProm();
	else if (memorySelect == 8)
	  statusByteMemory = WriteEEProm();
	else if (memorySelect != 0)
	  statusByteMemory = 4;

	memorySelect = 0;
}
/**
 * @brief Read flash memory in CPU
 * @param none
 */
UNS8 ReadLocalFlashMemory(void)
{
  UNS8 RMDataSize = sizeof(ReadMemoryData);
  UNS16 recordSize = FLASH_RECORD_SIZE;

  if (AddressRequest > (FLASH_SIZE - recordSize))
    return 2;

  if (lastRequestedAddress != AddressRequest || (triggerReadMemory == 1))
  {
    // set pattern to clear if read
    memset( ReadMemoryData, 0xA5, sizeof(ReadMemoryData));
    ReadLocalFlashData( AddressRequest, ReadMemoryData, recordSize );
    // now copy requested address into the top of the array
    ReadMemoryData[RMDataSize - 4] = (UNS8) AddressRequest;
    ReadMemoryData[RMDataSize - 3] = (UNS8)(AddressRequest >> 8);
    ReadMemoryData[RMDataSize - 2] = (UNS8)(AddressRequest >> 16);
    ReadMemoryData[RMDataSize - 1] = (UNS8)(AddressRequest >> 24);

    lastRequestedAddress = AddressRequest;
    triggerReadMemory = 0;
    return 0;
  }
  return 1;
}
/**
 * @ingroup eeprom
 * @brief used with handshake through the OD at 0x2020 to allow remote reading of
 *        values in the emulated eeprom memory
 */
UNS8 ReadEEProm(void)
{
  UNS8 RMDataSize = sizeof(ReadMemoryData);
  UNS16 recordSize = EEPROM_RECORD_SIZE;

  if (AddressRequest > (EEPROM_MEMORY_SIZE - recordSize))
    return 2;

  if (lastRequestedAddress != AddressRequest || (triggerReadMemory == 1))
  {
    // set pattern to clear if read
    memset( ReadMemoryData, 0xA5, sizeof(ReadMemoryData));
    EEPROM_read( (UNS16)AddressRequest, ReadMemoryData, recordSize );
    // now copy requested address into the top of the array
    ReadMemoryData[RMDataSize - 4] = (UNS8) AddressRequest;
    ReadMemoryData[RMDataSize - 3] = (UNS8)(AddressRequest >> 8);
    ReadMemoryData[RMDataSize - 2] = (UNS8)(AddressRequest >> 16);
    ReadMemoryData[RMDataSize - 1] = (UNS8)(AddressRequest >> 24);

    lastRequestedAddress = AddressRequest;
    triggerReadMemory = 0;
    return 0;
  }
  return 1;
}

/**
 * @ingroup eeprom
 * @brief used with handshake through the OD at 0x2020 to allow remote writing of
 *        a single value in the emulated eeprom memory
 */
UNS8 WriteEEProm ( void )
{
  UNS8 status = 0;

  if (AddressRequest > EEPROM_MEMORY_SIZE) // nominal address space
  {
    return 2;
  }
  else
  {
	EEPROM_open();
    EEPROM_write((UNS16)AddressRequest, &writeByteMemory, 1);
    EEPROM_commit();
  }

  return status;

}


/* USER CODE END 4 */
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
