COSMIIC-Community/NOVA/64 Channel Recording Module/Design/Firmware/Implantables-NOVA-Application.ioc

Mcu.UserName=STM32U5A5QJIxQ
PA10.Signal=USART1_RX
PA11.Signal=FDCAN1_RX
PA12.Signal=FDCAN1_TX
PA8.Signal=RCC_MCO
PA9.Signal=USART1_TX
PB13.Signal=SPI2_SCK
PB14.Signal=SPI2_MISO
PB7.GPIO_Label=VINMON_EN
PB7.Signal=GPIO_Output
PC4.GPIO_Label=PC4_LED
PC4.Signal=GPIO_Output
PF2.GPIO_Label=DVDD_EMG_EN
PF2.Signal=GPIO_Output
PG0.Signal=GPIO_Output
PG12.GPIO_Label=FRAM_VDD
PG12.Signal=GPIO_Output
PG2.Signal=SPI1_SCK
PG3.Signal=SPI1_MISO
PG4.Signal=SPI1_MOSI
PG9.Signal=SPI3_SCK
