COSMIIC-Community/NOVA/64 Channel Recording Module/Design/Firmware/Core/Inc/main.h

#define FRAM_VDD_Pin GPIO_PIN_12
#define FRAM_VDD_GPIO_Port GPIOG
#define VINMON_EN_Pin GPIO_PIN_7
#define VINMON_EN_GPIO_Port GPIOB
#define DVDD_EMG_EN_Pin GPIO_PIN_2
#define DVDD_EMG_EN_GPIO_Port GPIOF
#define PC4_LED_Pin GPIO_PIN_4
#define PC4_LED_GPIO_Port GPIOC
#define START_DELAY_MS  4UL	//to be multiplied by nodeID on startup
