COSMIIC-Community/NOVA/64 Channel Recording Module/Design/Firmware/Core/Src/timer.c

/**
 * @file timer.c
 *
 * @date Created on: Oct 10, 2024
 * @author Jerry Ukwela (jeu6@case.edu)
 * @addtogroup CANFestival
 * @{
 * @defgroup timer Timer
 * @}
 */


#include <applicfg.h>
#include "timer.h"
#include "ObjDict.h"
#include "main.h"


/*  ---------  The timer table --------- */
s_timer_entry timers[MAX_NB_TIMER] = {{TIMER_FREE, NULL, NULL, 0, 0, 0},};

TIMEVAL total_sleep_time = TIMEVAL_MAX;
TIMER_HANDLE last_timer_raw = -1;

#define min_val(a,b) ((a<b)?a:b)

/**
 * @ingroup timer
 * @brief Set an alarm to execute a callback function when expired.
 * @param *d Pointer to a CAN object data structure
 * @param id The alarm Id
 * @param callback A callback function
 * @param value Call the callback function at current time + value
 * @param period Call periodically the callback function
 * @return handle The timer handle
 */
TIMER_HANDLE SetAlarm(CO_Data* d, UNS32 id, TimerCallback_t callback, TIMEVAL value, TIMEVAL period)
{
	TIMER_HANDLE row_number;
	s_timer_entry *row;


	/* in order to decide new timer setting we have to run over all timer rows */
	for(row_number=0, row=timers; row_number <= last_timer_raw + 1 && row_number < MAX_NB_TIMER; row_number++, row++)
	{

        if (callback && 	/* if something to store */
		   row->state == TIMER_FREE) /* and empty row */
		{	/* just store */
			TIMEVAL real_timer_value;
			TIMEVAL elapsed_time;

			if (row_number == last_timer_raw + 1) last_timer_raw++;

			elapsed_time = getElapsedTime();
			/* set next wakeup alarm if new entry is sooner than others, or if it is alone */
			real_timer_value = value;
			real_timer_value = min_val(real_timer_value, TIMEVAL_MAX);

			if (total_sleep_time > elapsed_time && total_sleep_time - elapsed_time > real_timer_value)
			{
				total_sleep_time = elapsed_time + real_timer_value;
				setTimer(real_timer_value);
			}
			row->callback = callback;
			row->d = d;
			row->id = id;
			row->val = value + elapsed_time;
			row->interval = period;
			row->state = TIMER_ARMED;
            return row_number;
		}
	}
	return TIMER_NONE;
}

/**
 * @ingroup timer
 * @brief Delete an alarm before expiring.
 * @param handle A timer handle
 * @return The timer handle
 */
TIMER_HANDLE DelAlarm(TIMER_HANDLE handle)
{
	/* Quick and dirty. system timer will continue to be trigged, but no action will be preformed. */
    MSG_WAR(0x3320, "DelAlarm. handle = ", handle);
	if(handle != TIMER_NONE)
	{
		if(handle == last_timer_raw)
			last_timer_raw--;
		timers[handle].state = TIMER_FREE;
	}
	return TIMER_NONE;
}


int tdcount=0;
/**
 * @ingroup timer
 * @brief  TimeDispatch is called on each timer expiration ----
 */
void TimeDispatch(void)
{
	TIMER_HANDLE i;
	TIMEVAL next_wakeup = TIMEVAL_MAX; /* used to compute when should normaly occur next wakeup */
	//TIMEVAL next_wakeup = 0x8000; /* used to compute when should normaly occur next wakeup */
	/* First run : change timer state depending on time */
	/* Get time since timer signal */

    UNS32 overrun = (UNS32)getElapsedTime();

	TIMEVAL real_total_sleep_time = total_sleep_time + overrun;

	s_timer_entry *row;

	for(i=0, row = timers; i <= last_timer_raw; i++, row++)
	{
		if (row->state & TIMER_ARMED) /* if row is active */
		{
			if (row->val <= real_total_sleep_time) /* to be trigged */
			{
				if (!row->interval) /* if simply outdated */
				{
					row->state = TIMER_TRIG; /* ask for trig */
				}
				else /* or period have expired */
				{
					/* set val as interval, with overrun correction */
                                  /* modulo for 64 bit not available on all platforms     */
					row->val = row->interval - (overrun % (UNS32)row->interval); //JML
					row->state = TIMER_TRIG_PERIOD; /* ask for trig, periodic */
					/* Check if this new timer value is the soonest */
					if(row->val < next_wakeup)
						next_wakeup = row->val;
				}
			}
			else
			{
				/* Each armed timer value in decremented. */
				row->val -= real_total_sleep_time;

				/* Check if this new timer value is the soonest */
				if(row->val < next_wakeup)
					next_wakeup = row->val;
			}
		}
	}

	/* Remember how much time we should sleep. */
	total_sleep_time = next_wakeup;

	/* Set timer to soonest occurence */
	setTimer(next_wakeup);

	/* Then trig them or not. */
	for(i=0, row = timers; i<=last_timer_raw; i++, row++)
	{
		if (row->state & TIMER_TRIG)
		{
			row->state &= ~TIMER_TRIG; /* reset trig state (will be free if not periodic) */
			if(row->callback)
                        {
 				(*row->callback)(row->d, row->id); /* trig ! */
	                  }
		}
	}

}
