COSMIIC-Community/NOVA/64 Channel Recording Module/Design/Firmware/Core/Inc/boot.h

/**
 * @file boot.h
 *
 *  Created on: Oct 11, 2024
 *      Author: jenej
 */

#ifndef INC_BOOT_H_
#define INC_BOOT_H_

#include "data.h"

UNS8 processBOOT(CO_Data* d, Message* m);

#endif /* INC_BOOT_H_ */
