COSMIIC-Community/NOVA/(notices)

Notices in the files:
64 Channel Recording Module/Design/Firmware/Core/Inc/main.h:
Copyright (c) 2026 STMicroelectronics.
All rights reserved.
This software is licensed under terms that can be found in the LICENSE file
parts and their libraries:
1SS416L3M: COPYRIGHT: Copyright (C) 2022 Ultra Librarian. All rights reserved.
SN74LVC1G374DCKR: COPYRIGHT: Copyright (C) 2023 Ultra Librarian. All rights reserved.
